Noniwx/Diplom/Диплом/пупупупу/IMG_20250822_150141786.jpg

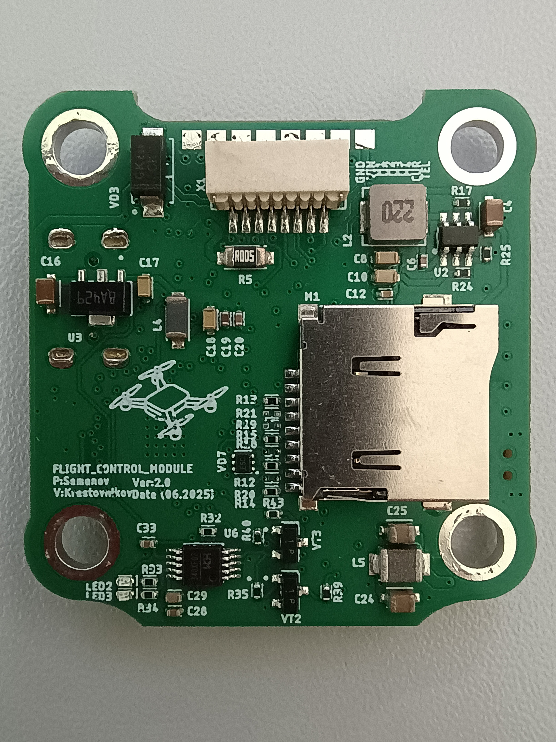
Диплом/пупупупу/IMG_20250822_150141786.jpg
