Noniwx/Diplom/Диплом/пупупупу/IMG_20250822_150113058.jpg

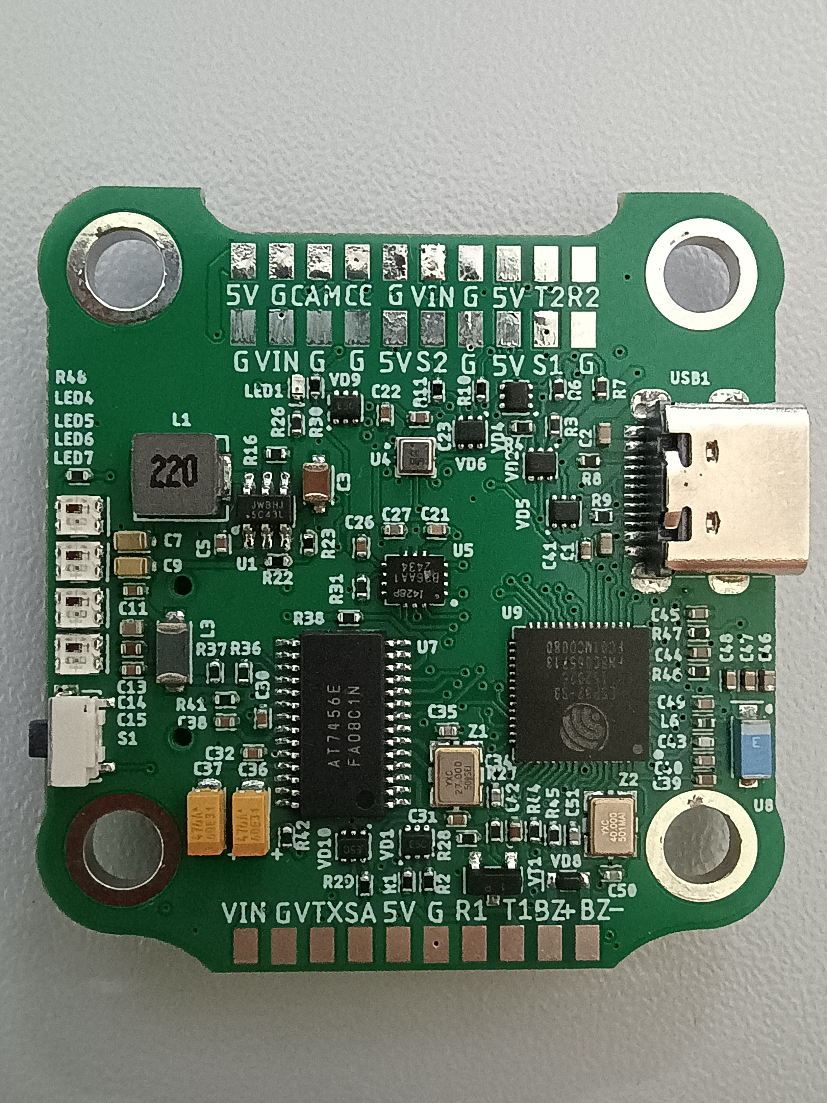
Диплом/пупупупу/IMG_20250822_150113058.jpg
