Noniwx/Diplom/Диплом/План разделов бакалаврской работы.docx

План разделов бакалаврской работы

Тема: Разработка аппаратного решения полётного контролёра FPV БПЛА на базе

микроконтроллера ESP32 [cite: 1]

Автор: Калистратов Яромир Викторович [cite: 1]

Введение

● Определение беспилотного воздушного судна (БВС) и специфика технологииFirst-Person View (FPV)

● Проблема зависимости современного рынка от микроконтроллеров семействаSTM32, приводящая к стагнации новых инженерных решений

● Недостатки одноядерной архитектуры в условиях жесткого реального времени, включая микрозадержки и пропуски тактов управления моторами

● Ограниченность физических интерфейсов в классических решениях (нехватка UART, I2C, SPI)

1. Обзорно-аналитическая часть

1.1 Анализ готовых решений

В разделе проводится детальный сравнительный анализ существующих серийных

полётных контроллеров [cite: 1]:

Модель контроллера Микроконтроллер Ключевые особенности

SpeedyBee F405 V4 [cite: 1] STM32F405 [cite: 1] Высокая интеграция, 6

UART, поддержка Bluetooth

Pixhawk 4 [cite: 1] STM32F765 + STM32F100

[cite: 1]

Для сложных автопилотных

комплексов, богатая

периферия

Matek F405-WTE [cite: 1] STM32F405RGT6 [cite: 1] Наличие Wi-Fi telemetry, до

Модель контроллера Микроконтроллер Ключевые особенности

12 PWM-выходов

Omnibus F4 Pro [cite: 1] STM32F405 [cite: 1] Компактный бюджетный

вариант для базовых задач

стабилизации

1.2 Патентный поиск

● Анализ патентов RU 214483 U1 и RU 2189625 C1 на системы управления БПЛА

● Вывод об избыточной громоздкости запатентованных решений и необходимости

создания высокоинтегрированной архитектуры на базе единого чипа (SoC)

1.3 Постановка технического задания

● Формирование требований к питанию (6-27 В) и габаритам (42 х 39.6 х 8 мм, масса до

8,2 г)

● Выбор микроконтроллера ESP32-S3 в качестве вычислительного ядра

● Требования к сенсорам (IMU, барометр), OSD, записи на MicroSD и подключению

внешней периферии

3. Системное проектирование и

расчетно-теоретическая часть

3.1 Разработка структурной схемы

● Обоснование применения двухъядерного ESP32-S3FN8 для устранения

микрозадержек за счет разделения задач фильтрации и периферийной связи [cite:

1].

● Описание взаимодействия подсистем: комплекса пространственной ориентации,

видеотракта (OSD), каналов управления (ESC) и интерфейсов телеметрии

3.2 Выбор элементной базы

● Обоснование выбора SoC ESP32-S3FN8 с интегрированной Flash-памятью 8 МБ [cite:

1].

● Выбор импульсных (JW5026) и линейных (L78L33) преобразователей для

подсистемы питания

● Подбор сенсорного комплекса: IMU ICM-42688-P и барометр BMP581

● Обоснование чипа MAX7456 для наложения OSD и CH340X для USB-UART моста

3.3 Расчетно-теоретическая часть

● Оценка энергетического баланса: суммарное пиковое потребление составляет ~674

мА по линии 5.0 В

● Расчет номиналов (индуктивность 22 мкГн, выходная емкость) для импульсного

преобразователя JW5026

● Тепловой расчет линейного стабилизатора L78L33 (расчетная температура

кристалла 66.8 °C)

● Проектирование и расчет параметров пассивного RC-фильтра нижних частот для

АЦП измерения напряжения

3.4 Защита и электромагнитная совместимость (ЭМС)

● Использование TVS-диодов (SMAJ30A) и диодных сборок TPNUP4114 для защиты от

индуктивных выбросов ESC и электростатических разрядов

● Разделение цифровых и аналоговых контуров питания, применение локальной

развязки конденсаторами

● Организация механической виброразвязки печатной платы через силиконовые

демпферы для защиты MEMS-гироскопа

4. Решение задач

конструкторско-технологического проектирования

4.1 Выбор материалов и параметров печатной платы

● Применение стеклотекстолита марки FR-4 High-Tg (с температурой стеклования ≥

150 °C) для тепловой стабильности

● Разработка 4-слойной структуры (Stack-up): сигнальные слои (Top/Bottom) и

сплошные полигоны питания/заземления (Inner Power/GND)

● Выбор финишного покрытия ENIG (иммерсионное золочение) для надежного

монтажа компонентов с малым шагом

4.2 Компоновочные решения

● Математическое и физическое обоснование размещения IMU (ICM-42688-P) строго

в центре масс для исключения паразитных центростремительных ускорений

● Минимизация длины проводников высокочастотных шин SPI вокруг

микроконтроллера ESP32-S3

● Периферийное размещение импульсных DC-DC преобразователей для изоляции

электромагнитных помех и отвода тепла

4.3 Трассировка печатной платы

● Реализация импедансного контроля для дифференциальных пар USB (90 Ом) с

применением копланарного волновода

● Трассировка распределительной сети питания (PDN) с помощью заливки медных

полигонов

● Обеспечение непрерывности возвратного тока для защиты шины SPI и

экранирование аналоговых измерительных трактов

● Применение сшивки земляных полигонов (Via Stitching) для краевого экранирования

по принципу клетки Фарадея

4.4 Технологическое обеспечение сборки

● Мультиплицирование (панелизация) плат с использованием фрезеровки с

технологическими перемычками

● Трафаретная печать бессвинцовой паяльной пастой (SAC305) через стальной

трафарет

● Настройка четырехзонного температурного профиля оплавления (предварительный

нагрев, стабилизация, оплавление, охлаждение)

● Внедрение автоматической оптической (AOI) и рентгеновской (X-Ray) инспекции

для скрытых паяных соединений

4.5 Обеспечение теплового режима

● Локализация ключевых источников тепла: ESP32-S3, JW5026, L78L33

● Использование термальных площадок, тепловых переходных отверстий (Thermal

Vias) и внутренних медных слоев как планарных радиаторов для кондуктивного

отвода тепла

● Тепловая изоляция гироскопа от силовых узлов для предотвращения

температурного дрейфа нуля

● Использование фактора конвективного теплообмена за счет нисходящих

турбулентных потоков воздуха от пропеллеров БВС
