Noniwx/Diplom/Диплом/Расчёты.docx

Расчёты

1. Расчёт системы питания (DC-DC и LDO)

- Энергетический баланс (Бюджет мощности): Необходимо составить таблицу токопотребления всех узлов (ESP32-S3, датчики, OSD, внешняя периферия вроде приемника и GPS, светодиоды WS2812). Это обоснует выбор DC-DC преобразователей JW5026.

- Расчёт выходного напряжения DC-DC: Обоснование номиналов резисторов делителя в цепи обратной связи (FB) для получения 5V и 3.3V.

V_(out) =V_(REF) ∙(1+(V_(top))/(V_(bottom)))

- Расчёт индуктивности дросселя (L1, L2): Демонстрация того, почему выбраны именно $22\text{ \mu H}$. Расчёт пульсаций тока дросселя ($\Delta IL$) в зависимости от входного напряжения (например, от 4S или 6S LiPo), частоты переключения и выходного тока.

$$L = \frac{V{OUT} \cdot (V{IN} - V{OUT})}{V{IN} \cdot f{SW} \cdot \Delta IL}$$

- Расчёт пульсаций выходного напряжения и выбор конденсаторов: Обоснование емкости и типа (ESR) выходных конденсаторов для обеспечения стабильности.

- Тепловой расчёт линейного стабилизатора (L78L33): Он питает чувствительную аналоговую часть или датчики. Нужно рассчитать рассеиваемую мощность при падении с 5V до 3.3V и доказать, что он не перегреется без радиатора:

$$PD = (V{IN} - V{OUT}) \cdot I{LOAD}$$

$$TJ = TA + PD \cdot \theta{JA}$$

2. Расчёт высокочастотных цепей и тактирования

Поскольку используется микроконтроллер с радиомодулем и высокоскоростные шины, этот блок покажет твои компетенции в СВЧ.

- Согласование волнового сопротивления антенны: Расчёт ширины микрополосковой линии от вывода LNAIN ESP32 до разъема антенны для обеспечения импеданса $50\text{ Ом}$. Это потребует указания параметров стека печатной платы (материал FR4, толщина диэлектрика, толщина меди).

- Расчёт нагрузочной емкости кварцевого резонатора (40 МГц): Обоснование выбора конденсаторов $22\text{ pF}$ (C49, C50) на основе паразитной емкости монтажа ($C{stray}$) и спецификации самого кварца:

$$CL = \frac{C1 \cdot C2}{C1 + C2} + C_{stray}$$

3. Расчёт сигнальных и измерительных цепей

Этот блок покажет понимание работы с аналоговыми сигналами и защитой.

- Расчёт делителя напряжения для АЦП (Мониторинг батареи): На разъеме X1 (Sheet 1/4) есть вход VIN, который через делитель (R5, R6, R7 - нужно уточнить номиналы на схеме, там указано $0.005$ для шунта и делитель для напряжения) идет на АЦП. Нужно рассчитать коэффициент деления так, чтобы максимальное напряжение батареи (например, $25.2\text{ V}$ для 6S) не превышало опорное напряжение АЦП ESP32.

- Токоизмерительный шунт: Расчёт падения напряжения на шунте (если он установлен на плате) или расчёт цепи усилителя токового сигнала с ESC. Обоснование рассеиваемой на шунте мощности $P = I^2 \cdot R$.

- Ограничительные резисторы для светодиодов: Классический, но обязательный расчёт резисторов для индикаторных LED, чтобы ток не превысил возможности пинов MCU.

4. Конструкторско-технологические расчёты (Для ГОСТ/ЕСКД)

Если комиссия любит классическую школу проектирования, эти пункты добавят работе огромный вес.

- Расчёт надежности (Наработка на отказ - MTBF): Приблизительный расчет вероятности безотказной работы платы в течение заданного времени на основе интенсивности отказов компонентов (по справочникам или MIL-HDBK-217F). Для полетного контроллера FPV, который подвергается вибрациям и крашам, это очень интересный пункт.

- Оценка габаритов и трассировки: Обоснование выбора класса точности печатной платы (ширина проводников/зазоры) исходя из протекающих токов (особенно в цепях питания от батареи).

С какого раздела расчётов ты бы хотел начать детальную проработку для добавления в текст пояснительной записки?
