Noniwx/Diplom/Диплом/1.docx

1.1 Анализ существующих аппаратных платформ полетных контроллеров и их архитектурных ограничений

Основой любого современного БВС является полетный контроллер, который определяет функциональные возможности аппарата и его итоговую стоимость. Однако на сегодняшний день достижение баланса между высокой производительностью и экономической доступностью существенно затруднено. Анализ готовых проектов с открытым аппаратным обеспечением показывает, что подавляющее большинство современных полетных контроллеров базируется на 32-битных микроконтроллерах семейства STM32 (таблица 1).

Таблица 1 - Сравнение микроконтроллеров, датчиков и лицензий для платформ полетных контроллеров с открытым аппаратным обеспечением [2]

Тотальная зависимость рынка от чипов семейства STM32 стала причиной формирования весьма консервативной экосистемы. Популярные открытые проекты, наподобие Pixhawk, изначально создавались с оглядкой именно на эту архитектуру. В результате инженеры оказались зажаты в строгие рамки, так как выбор компонентов сильно ограничен, а любые попытки выйти за пределы аппаратной линейки, сталкиваются с серьезными трудностями.

При глубоком рассмотрении технической стороны вопроса, базовая проблема таких полетных контроллеров кроется в использовании всего одного вычислительного ядра. Логика управления полетом требует работы в реальном времени, из-за чего все ключевые процессы, а именно чтение показаний датчиков, математика ПИД-регуляторов и программная очистка сигналов от шума - выстраиваются в единую последовательную очередь. Как только применяемые алгоритмы усложняются, к примеру, добавляется тяжелая динамическая RPM-фильтрация, процессор начинает банально не справляться с потоком вычислений. Возникает задержка базового рабочего цикла, плата пропускает такты управления двигателями, и БВС теряет стабильность в воздухе.

Также к вычислительным ограничениям, при проектировании постоянно возникает проблема дефицита физических портов связи. Для полноценного функционирования современного БВС к нему необходимо одновременно подключить модуль навигации, камеру и двустороннюю телеметрию. В недорогих микроконтроллерах такого количества независимых линий связи нет. Инженерам приходится искать компромиссы: делить одну шину между несколькими устройствами или эмулировать порты программными средствами. На практике же такие обходные пути ведут к конфликтам контроллеров прямого доступа к памяти и потере пакетов данных.

Для разработки полетного контроллера необходимо подобрать оптимальный микроконтроллер. Для этого провести сравнительный анализ современных микропроцессоров. В качестве объектов для сравнения выбраны три актуальные микроконтроллера: STM32F405, RP2040 и ESP32-S3.

1.2.1 Микроконтроллер STM32F405

Микроконтроллер семейства STM32 является наиболее распространенным решением, применяемым в подавляющем большинстве современных полетных контроллеров для FPV-систем.

- Архитектура: ARM Cortex-M4;

- Количество ядер: 1;

- Максимальная тактовая частота: 168 МГц;

- Аппаратная поддержка FPU-есть;

- Беспроводные интерфейсы-нет

- Особенности ввода-вывода: аппаратные шины, UART, I2C, SPI, имеют жесткую привязку к конкретным физическим выводам чипа.

1.2.2 Микроконтроллер RP2040

Микроконтроллер RP2040 представляет собой современное бюджетное решение с уникальной подсистемой программируемого ввода-вывода, набирающее популярность в DIY-электронике.

- Архитектура: ARM Cortex-M0+;

- Количество ядер: 2;

- Максимальная тактовая частота: 133 МГц;

- Аппаратная поддержка FPU -нет

- Беспроводные интерфейсы -нет

- Особенности ввода-вывода: программируемые блоки ввода-вывода PIO, позволяющие эмулировать интерфейсы на любых выводах.

1.2.3 Микроконтроллер ESP32-S3

Микроконтроллер ESP32-S3 - высокопроизводительная система на кристалле SoC с фокусом на интеграцию беспроводных технологий и параллельные вычисления.

- Архитектура: Xtensa LX7;

- Количество ядер: 2;

- Максимальная тактовая частота: 240 МГц;

- Аппаратная поддержка FPU -есть;

- Беспроводные интерфейсы: встроенные Wi-Fi 4 и Bluetooth 5;

- Особенности ввода-вывода: аппаратный матричный коммутатор GPIO Matrix, позволяющий произвольно назначать периферийные шины на любые физические выводы.

Для наглядного сопоставления ключевых параметров рассмотренных вычислительных платформ составлена сводная таблица (таблица 1.2).

Таблица 1.2 - Сравнительная характеристика микроконтроллеров

Название | STM32F405 | RP2040 | ESP32-S3
Архитектура | ARM Cortex-M4 | ARM Cortex-M0+ | Xtensa LX7
Количество ядер | 1 | 2 | 2
Максимальная тактовая частота | 168 МГц | 133 МГц | 240 МГц
Аппаратный FPU | Есть | Нет | Есть
Встроенная беспроводная связь | Нет | Нет | Wi-Fi 4, Bluetooth
Гибкость портов вывод-ввод | Низкая | Высокая | Высокая

Анализ характеристик показывает, что микроконтроллер ESP32-S3 является наиболее сбалансированным решением для разрабатываемого устройства. В отличие от STM32F405, он обладает двухъядерной архитектурой, позволяющей эффективно разделить вычислительные потоки контура стабилизации и навигации, а также имеет на борту встроенные радиомодули для организации беспроводной сервисной телеметрии. В отличие от RP2040, ядро ESP32-S3 оснащено аппаратным сопроцессором FPU, что является критически важным условием для быстрого расчета ПИД-регуляторов и цифровых фильтров без просадок по частоте главного цикла. Дополнительным фактором выбора служит наличие GPIO Matrix, что радикально упростит трассировку печатной платы при подключении внешних датчиков.

Для выполнения требований методических указаний в данном подразделе необходимо провести патентное исследование. Цель поиска - анализ существующих запатентованных технических решений в области архитектуры и компоновки бортовых полетных контроллеров для беспилотных летательных аппаратов, а также подтверждение патентной чистоты разрабатываемого устройства.

Поиск проводился по фондам Федерального института промышленной собственности (ФИПС), а также по международным базам данных (Espacenet, Google Patents) с использованием индексов Международной патентной классификации (МПК): B64C 39/02 (беспилотные авиационные системы) и G05D 1/00 (управление или регулирование положения в пространстве).

Ниже приведены результаты анализа наиболее близких по технической сущности патентов.

1.3.1 Патент РФ No 2712534 "Бортовой модульный комплекс управления беспилотным летательным аппаратом"

- Правообладатель: АО "Концерн "Вега"

- Суть технического решения: Патент описывает архитектуру модульного полетного контроллера, построенного на базе центрального вычислителя и распределенной сети датчиков пространственной ориентации. Связь между модулями внутри устройства осуществляется по помехозащищенной шине.

- Достоинства: Высокая отказоустойчивость за счет дублирования измерительных каналов и модульной структуры.

- Недостатки и отличия: Высокая сложность аппаратной реализации, избыточная для малых FPV-систем масса и габариты, а также высокая стоимость элементной базы. В разрабатываемом проекте вместо громоздкой модульной структуры применяется моноблочная печатная плата на базе высокоинтегрированной системы на кристалле (SoC).

1.3.2 Патент США (US) No 11249492 "Flight Controller for Unmanned Aerial Vehicles with Integrated Wireless Interface"

- Правообладатель: SZ DJI Technology Co., Ltd.

- Суть технического решения: Изобретение относится к архитектуре полетного контроллера со встроенным на кристалл или печатную плату высокочастотным приемопередатчиком для передачи сервисных данных, телеметрии и настройки конфигурации без использования проводных интерфейсов.

- Достоинства: Улучшенные массогабаритные показатели (SWaP) за счет исключения внешних мостов связи и интерфейсных микросхем.

- Недостатки и отличия: Заявленное в патенте решение базируется на закрытой проприетарной архитектуре и специализированных чипах связи, что делает невозможным его использование в бюджетных открытых платформах. Разрабатываемый проект использует схожий концептуальный подход (встроенный радиоканал), но реализует его на базе общедоступного микроконтроллера ESP32-S3 и открытых протоколов, что снижает себестоимость платы.

Сводная таблица патентного поиска

Для наглядного сравнения патентных решений и разрабатываемого устройства составлена таблица 1.3.

Таблица 1.3 - Матрица сравнения патентных решений

| Критерий сравнения | Патент РФ No 2712534 | Патент US No 11249492 | Разрабатываемое устройство |

| Конструктивное исполнение | Модульное (многоплатное) | Моноблочное | Моноблочное (одна печатная плата) |

| Аппаратная база | Проприетарные вычислители | Специализированная SoC DJI | Общедоступный SoC ESP32-S3 |

| Интегрированная беспроводная связь | Нет | Есть (закрытый протокол) | Есть (открытые Wi-Fi / Bluetooth) |

| Целевой сегмент рынка | Тяжелые БАС (спец. назначение) | Гражданские коммерческие БВС | Доступные FPV-системы, DIY |

Вывод по патентному поиску:

Анализ патентной документации показывает, что архитектурные решения, закладываемые в разрабатываемый полетный контроллер (моноблочная плата на базе ESP32-S3 с интегрированными датчиками и встроенным сервисным беспроводным интерфейсом), обладают патентной чистотой. Проектируемое устройство не нарушает действующих прав патентных правообладателей, так как базируется на принципиально иной, общедоступной элементной базе и оригинальной топологии печатной платы, адаптированной под жесткие экономические рамки гражданских FPV-систем.

2.1 Разработка структурной схемы полетного контроллера

Системное проектирование аппаратного модуля начинается с определения его ключевых функциональных узлов, необходимых для выполнения поставленного технического задания. Центральным координирующим ядром разрабатываемой системы является микроконтроллер ESP32-S3FN8. Для обеспечения полного цикла управления беспилотным воздушным судном - от сбора телеметрии до выдачи корректирующих воздействий на моторы - вокруг центрального процессора формируется инфраструктура из следующих логических подсистем:

1. Подсистема питания и мониторинга

Первичным источником энергии на борту выступает аккумуляторная батарея. Подсистема питания предназначена для понижения и стабилизации входного напряжения до уровней, необходимых для корректной работы центрального микроконтроллера и чувствительной периферии. Параллельно с этим в систему закладывается блок измерения напряжения, который непрерывно опрашивает состояние батареи и передает данные в микроконтроллер для контроля уровня разряда и предотвращения аварийных ситуаций.

2. Измерительный комплекс

Для реализации алгоритмов стабилизации микроконтроллеру требуется непрерывный поток данных о пространственном положении аппарата. В этот комплекс входят инерциальный датчик пространственного положения (гироскоп и акселерометр) и барометр для определения абсолютной высоты. Обмен данными между датчиками и процессором осуществляется по высокоскоростным цифровым шинам.

3. Видеоподсистема

Отвечает за формирование FPV-сигнала. Аналоговый видеопоток с курсовой камеры поступает в специализированный модуль OSD. В этом блоке центральный микроконтроллер аппаратно накладывает на видеоряд полетную

телеметрию. Сформированный сигнал передается на видеопередатчик для трансляции на приемное оборудование пилота.

4. Подсистема связи и внешних интерфейсов

Обеспечивает взаимодействие контроллера с оператором и внешним миром. В нее входят:

- Приемник ELRS для получения управляющих команд с пульта пилота;
- Приемник GPS для определения глобальных координат;
- Модуль SD-CARD для непрерывного логирования полетных данных;
- USB-интерфейс, позволяющий осуществлять сервисную настройку и прошивку контроллера с персонального компьютера.

5. Блок исполнительных устройств и индикации

На основе математических расчетов ПИД-регулятора микроконтроллер формирует управляющие сигналы, которые передаются на блок регуляторов оборотов. Регуляторы скорости коммутируют силовые токи для вращения бесколлекторных моторов. Дополнительно предусмотрены выходы для управления сервоприводами и блок индикации для обеспечения визуальной и звуковой обратной связи с пилотом на земле.

На основе описанных выше функциональных узлов и связей между ними была разработана структурная схема полетного контроллера, наглядно отражающая направления информационных и энергетических потоков (рисунок 2.1).

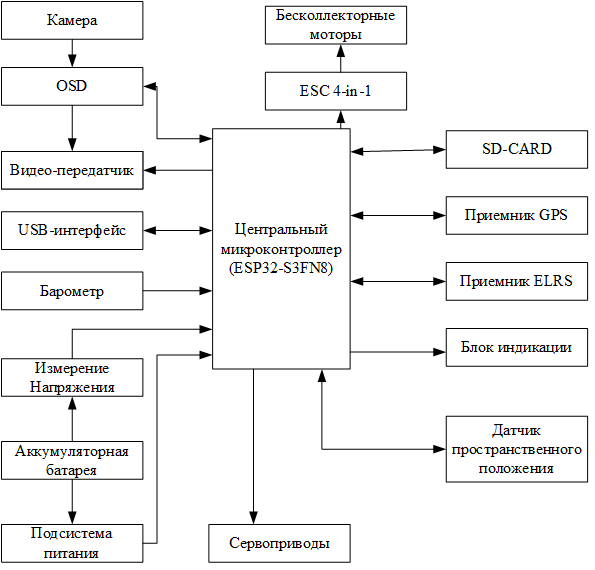
[picture p13: figure]

Рисунок 2.1 - Структурная схема полетного контроллера

Данная структура полностью покрывает аппаратные потребности разрабатываемого устройства и служит строгим базисом для последующей разработки функциональной и принципиальной электрических схем.
