Noniwx/Diplom/Диплом/ВВЕДЕНИЕ.docx

Беспилотное воздушное судно представляет собой летательный аппарат, который выполняет полет без экипажа на борту и управляется дистанционно внешним пилотом либо функционирует в полностью автономном режиме. Законодательно закрепленная формулировка определяет его как "Беспилотное воздушное судно - воздушное судно, управляемое, контролируемое в полете пилотом, находящимся вне борта такого воздушного судна (внешний пилот). " [1]. Развитие подобных систем стало возможным благодаря уменьшению электронных компонентов, что позволило превратить тяжелые комплексы в компактные маневренные платформы, пригодные для решения широкого спектра задач.

Аппаратная часть современных беспилотных воздушных суден базируется на несущей конструкции- раме, силовой установке, которая представляет собой набор из бесколлекторных двигателей и электронных регуляторов скорости, источнике питания и полётном контроллере, который выступает главным вычислительным узлом для обработки данных с датчиков и стабилизации. Конструктивно такие аппараты делятся на несколько основных классов, среди которых для решения тактических и маневренных задач доминируют крылатые и роторные платформы [2]. Среди роторных систем очень хорошо выделяются системы, с технологией First-Person View, что дословно переводится как «вид от первого лица». Суть этой технологии заключается в непрерывной передаче видеопотока с бортовой камеры на очки или монитор пользователя с минимальными задержками. Это дает оператору БВС эффект нахождения непосредственно в кабине и позволяет выполнять сложные пространственные маневры на высоких скоростях, быстро реагировать, а также огибать препятствия.

Именно способность FPV БВС и мультироторных систем маневрировать в труднодоступных местах позволила их массовое внедрение различные секторы гражданской авиации. Беспилотные воздушные судна стали стандартным инструментом для решения задач, где требуется оперативный сбор пространственных данных или визуальный контроль. Они активно применяются для инспекции строительных площадок, мониторинга сельскохозяйственных угодий, обеспечения безопасности и проведения поисково-спасательных работ [3]. Применение БВС исключает риск для жизни человека при обследовании опасных зон, таких как очаги возгораний или разрушенные здания, делая разработку доступной аппаратной базы для таких устройств критически важной задачей.

Массовое внедрение БВС в различные секторы гражданской авиации требуют создания экономически эффективных аппаратных решений. Однако достижение баланса между низкой себестоимостью и высокой производительностью существенно затруднено текущим состоянием рынка электронных компонентов. Подавляющее большинство современных аппаратных решений для FPV-систем жестко привязано к микроконтроллерам семейства STM32 (таблица 1) с архитектурой ARM Cortex-M. Исторически эта архитектура стала базовой для ключевых проектов с открытым исходным кодом, таких как Betaflight и INAV, что привело к формированию стандартизированной, но замкнутой аппаратно-программной экосистемы [4]. Данная унификация упрощает сборку типовых летательных аппаратов, однако накладывает жесткие рамки на компонентную базу. Следствием подобной монополизации является критическое снижение инженерной гибкости при проектировании новых систем управления. Разработчики полетных контроллеров оказываются в зависимости от конкретной компании и узкой линейки процессоров. В ситуациях, требующих максимального снижения себестоимости платы или глубокой аппаратной интеграции беспроводных интерфейсов связи, безальтернативная опора на STM32 становится фундаментальным препятствием для перехода на альтернативные вычислительные платформы и снижение итоговой стоимости плат.

Таблица 1 - Сравнительный анализ аппаратных платформ полетных контроллеров (по данным [4])

Главным недостатком классической архитектуры микроконтроллеров, доминирующих на рынке БВС, является использование одного вычислительного ядра. Система управления полетом функционирует в режиме жесткого реального времени и требует непрерывного выполнения вложенных циклов, где абсолютным приоритетом обладает высокочастотный внутренний контур стабилизации [5]. В одноядерной системе опрос гироскопов, расчет ПИД-регуляторов, фильтрация шумов и обработка входящих команд от пилота выполняются строго последовательно. При усложнении математического аппарата, например, при внедрении ресурсоемких алгоритмов динамической RPM-фильтрации, единственное ядро подвергается критическим перегрузкам. Последовательная обработка возрастающего потока данных приводит к неизбежным задержкам времени выполнения базового цикла [4]. Возникающие микрозадержки вызывают пропуски тактов управления моторами, что напрямую снижает стабильность БВС.

Аппаратные ограничения вычислительного ядра дополнительно усугубляются нехваткой физических интерфейсов для взаимодействия с внешней периферией. Современные задачи требуют одновременного подключения к контроллеру цифровых систем видеопередачи, GPS-модулей, барометров и линий двунаправленной телеметрии. Для их интеграции требуются независимые аппаратные протоколы, такие как UART, I2C, SPI, однако их количество в недорогих чипах жестко ограничено, что наглядно отраженно на структурной схеме типового подключения периферии (рисунок 1) [6]. Исчерпание доступных аппаратных шин вынуждает прибегать к программной эмуляции протоколов или совместному использованию линий. Это провоцирует конфликты на уровне контроллеров прямого доступа к памяти, приводит к потере пакетов данных и делает классические контроллеры трудно масштабируемыми под требования современных систем.

Рисунок 1 - Структурная схема аппаратных конфликтов при подключении периферийных модулей
