Noniwx/Diplom/Диплом/пупупупу/Презентация1.pptx

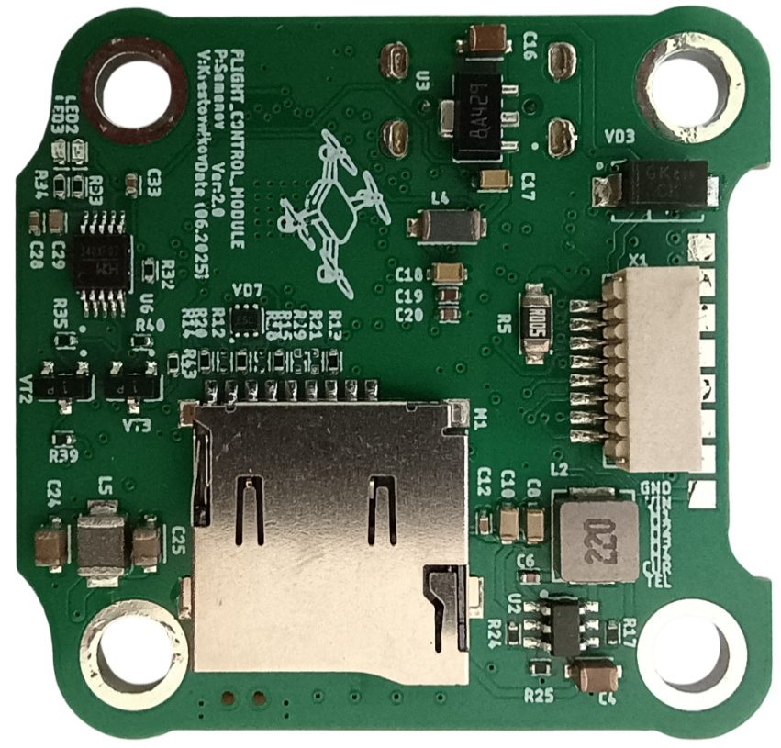
[picture p29: figure]
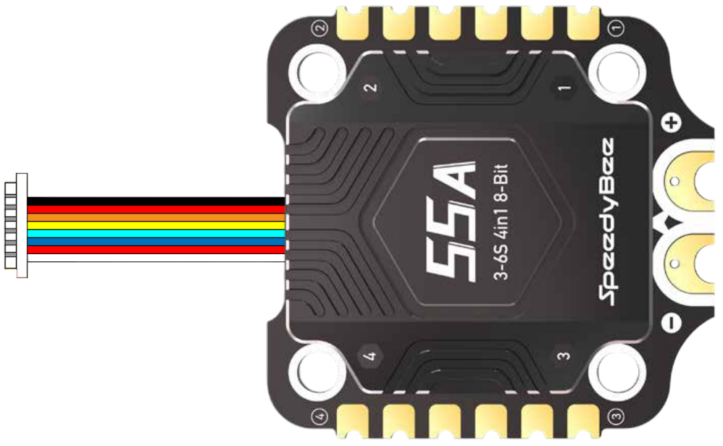
[picture p30: figure]

## Slide 2

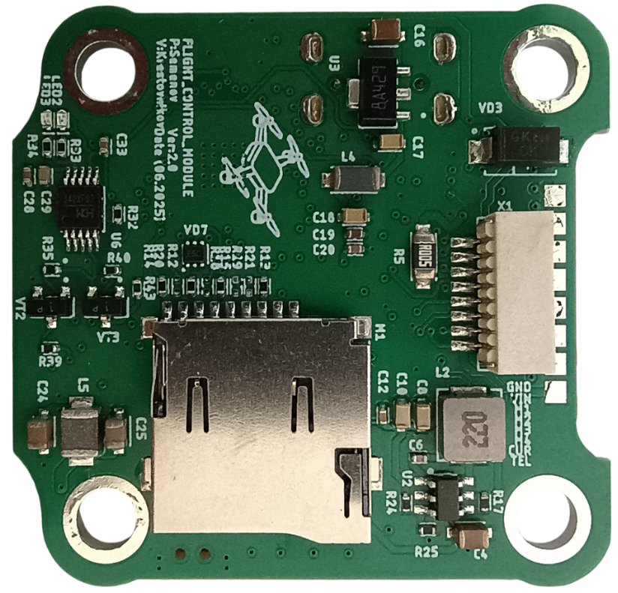
[picture p31: figure]
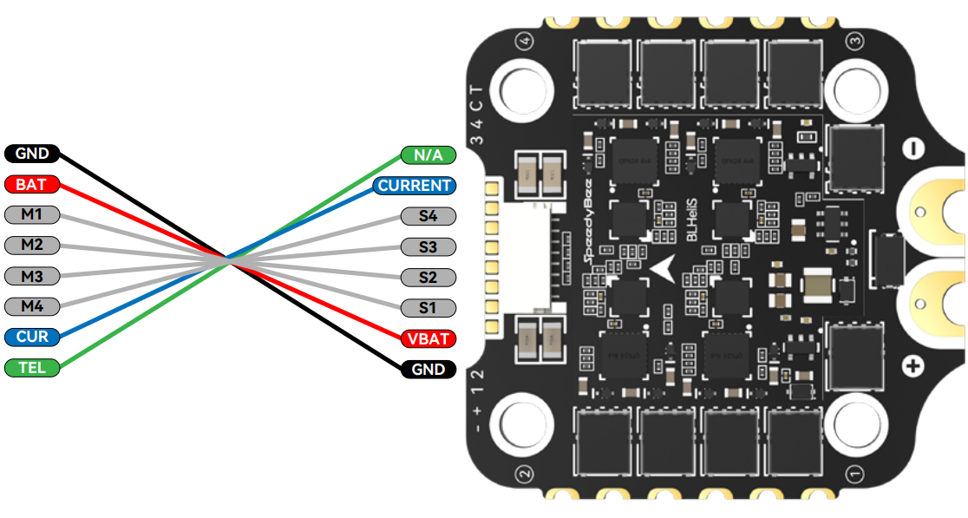
[picture p32: figure]

## Slide 3

DC-DC понижающий

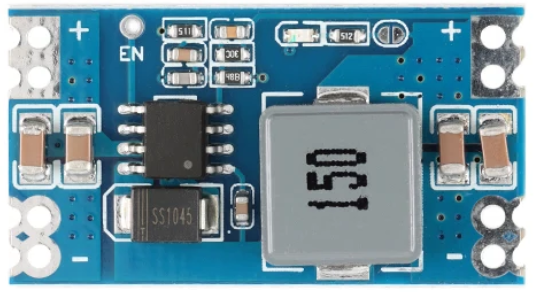
[picture p33: figure]

Сервопривод 1
(сброс, камера)

Сервопривод 2
(сброс, камера)

АКБ БпЛА

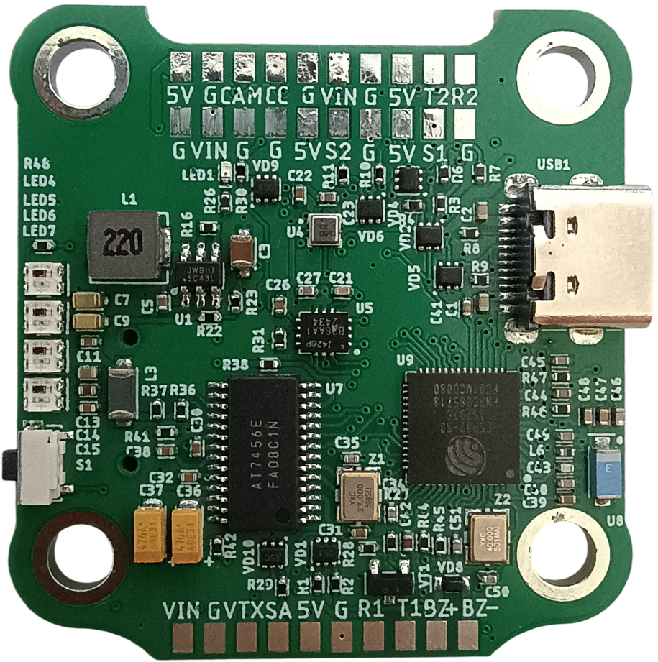
[picture p34: figure]

## Slide 4

DC-DC понижающий

Сервопривод 1
(сброс, камера)

Сервопривод 2
(сброс, камера)

АКБ БпЛА

Электрический
детонатор
промышленный
(ЭДП, ЭД-8)
