Noniwx/Diplom/Диплом/Structure.png

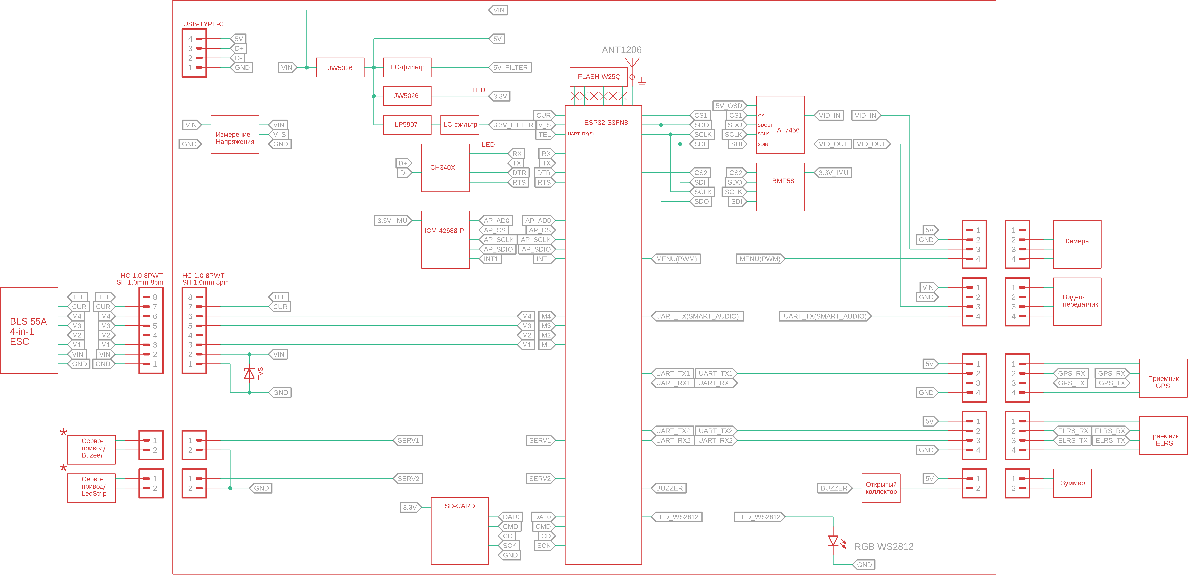
Диплом/Structure.png
