Noniwx/Diplom/Диплом/пупупупу/ESC-FC-Photoroom.png

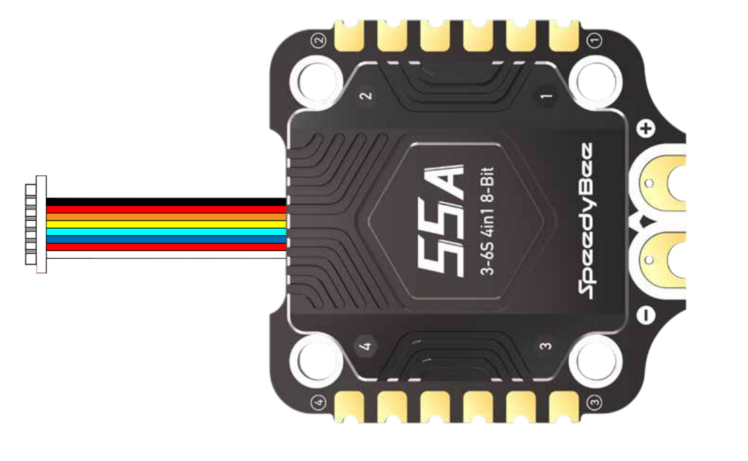
Диплом/пупупупу/ESC-FC-Photoroom.png
