Noniwx/Diplom/Диплом/пупупупу/GPS.png

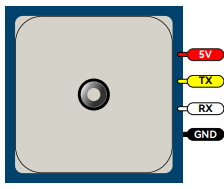
Диплом/пупупупу/GPS.png
