Noniwx/Diplom/Диплом/пупупупу/IMG_20250822_150113058-Photoroom.png

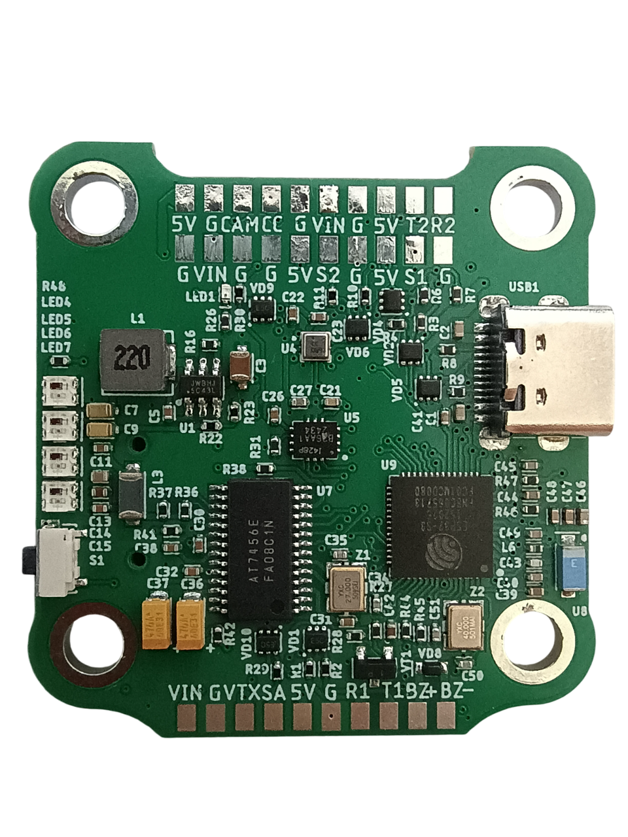
Диплом/пупупупу/IMG_20250822_150113058-Photoroom.png
