Noniwx/Diplom/Диплом/пупупупу/IMG_20250822_150141786-Photoroom.png

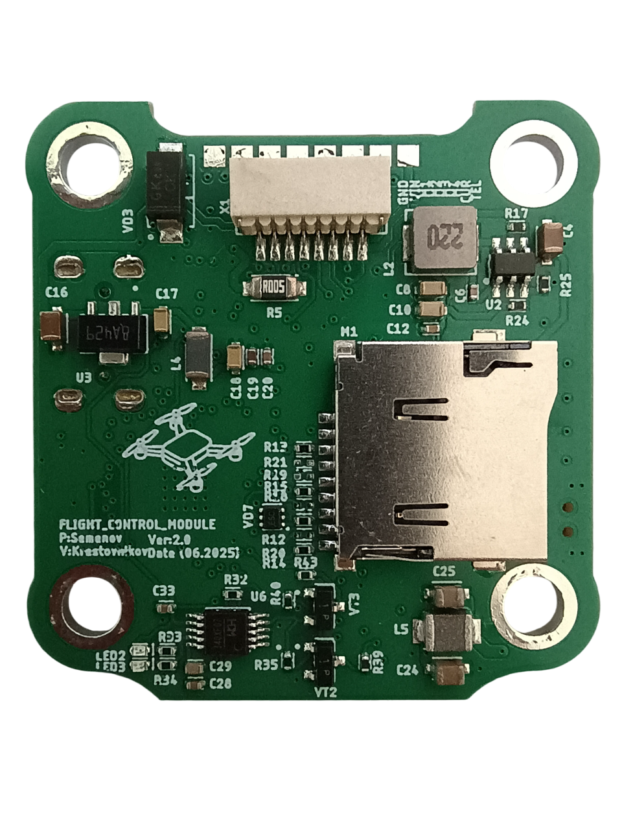
Диплом/пупупупу/IMG_20250822_150141786-Photoroom.png
