Noniwx/Diplom/Диплом/пупупупу/photo_2026-05-30_10-07-58.jpg

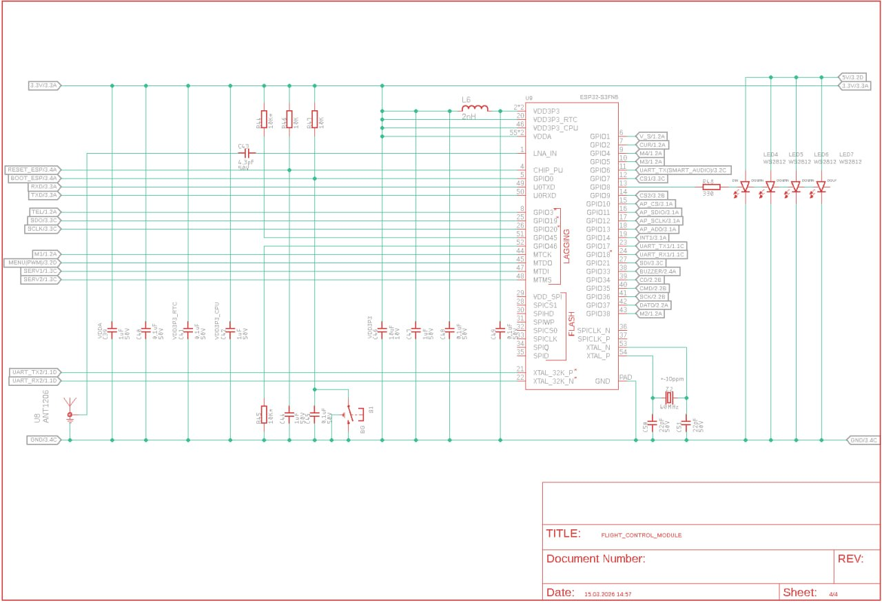
Диплом/пупупупу/photo_2026-05-30_10-07-58.jpg
