Noniwx/Diplom/Диплом/пупупупу/photo_2026-05-30_10-08-17.jpg

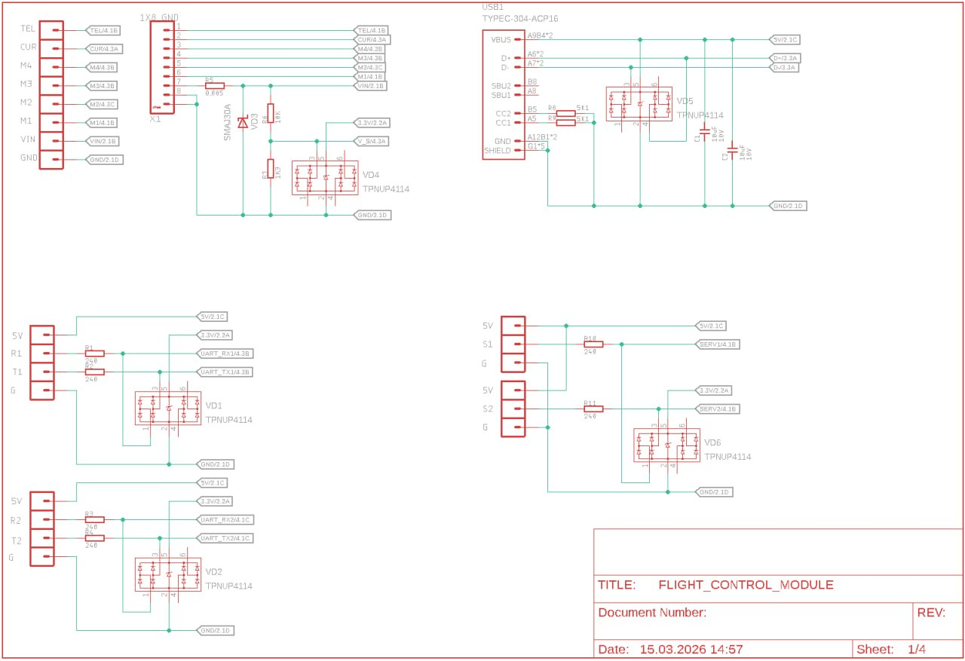
Диплом/пупупупу/photo_2026-05-30_10-08-17.jpg
