Noniwx/Diplom/Диплом/пупупупу/vtx.png

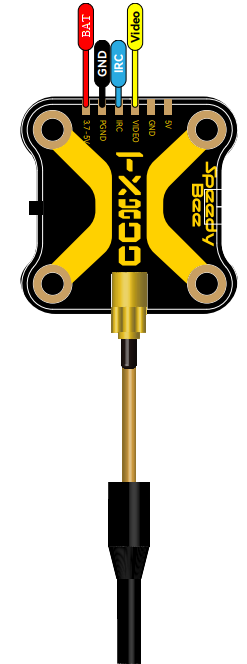
Диплом/пупупупу/vtx.png
