Noniwx/Diplom/Диплом/папапапа/BOM_FLIGHT_CONTROL_MODULE.pdf

Номер

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
Обозначение Элемента

C1, C2, C13, C29, C46
C14, C19, C39, C42, C44, C47 C21
C27
C36, C37
C5, C6, C11, C12, C15, C20, C22, C23, C26, C28, C30, C31, C32, C33, C38, C40, C41, C45, C48, C49
C3, C4, C16
C7, C8, C9, C10, C17, C18
С43
C24, C25
C34, C35, C50, C51

R1, R2, R3, R4, R10, R11, R12, R13, R14, R15, R29, R30 R5
R22
R23
R24
R25
R26, R27, R33, R34, R36, R37, R38, R39, R43 R32
R35, R40
R41, R42
R48
R6, R16, R17, R28, R31, R44, R45, R46, R47 R7
R8, R9

VD8
VD1, VD2, VD4, VD5, VD6, VD7, VD9, VD10 VD3

VT1, VT2, VT3

Z1
Z2

LED4, LED5, LED6, LED7
LED1, LED3
LED2

S1

U1, U2
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
USB1

L5
L3, L4
L1, L2
L6

U8

Количество | Парт номер
5 | CL05A106MP5NUNC 6 | GRM155R61H105KE05D 1 | CL05B103KB5NNNC 1 | CL05A225MQ5NSNC 2 | TLJA476M010R0600
20 | CL05B104KB54PNC 3 | CGA0805X5R226M350MT 6 | GRM188R60J476ME15D 1 | GJM1555C1H4R3CB01D 2 | CL21A475KBQNNNE 4 | 0402CG220J500NT
12 | RC0402FR-07240RL 1 | RLM12FTCMR005 1 | RC0402FR-0711K3L 1 | RC0402FR-072K1L 1 | 0402WGF7501TCE 1 | 0402WGF2401TCE 9 | 0402WGF1001TCE 1 | 0402WGF4701TCE 2 | 0402WGF4700TCE 2 | 0402WGF750JTCE 1 | 0402WGF3300TCE 6 | 0402WGF1002TCE 1 | RC0402FR-071K3L 2 | 0402WGF5101TCE 1 | 1N5819WS 8 | NUP4114UPXV6T1G-N 1 | SMAJ30A 3 | MMBT2222A 1 | X322527MSB4SI 1 | X322540MMB4SI

4 | WS2812B-2020 2 | SZYY0402R 1 | SZYY0402YG 1 | TS-1010-C-A 2 | JW5026 1 | L78L33ABUTR 1 | BMP581 1 | ICM-42688-P 1 | CH340X 1 | AT7456 1 | ESP32-S3FN8 1 | HC-1.0-8PWT 1 | GT-TF003-H0185-02 1 | TYPEC-304-ACP16 1 | SMMS0850-2R2M 2 | MGFL3216F100MT-LF 2 | SMMS0420-220M 1 | LQG15HS2N0S02D 1 | RFANT3216120A5T

Описание/номинал

10uF
1uF
10nF
2.2uF
47uF

100nF

22uF
47uF
4.3pF
4.7uF
22pF

240
0.005Ω
11K3
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
Electrostatic and Surge Protection SMAJ30A

40V 300mW 600mA NPN

27MHz
40MHz Surface mount crystal oscillator 10pF ±10ppm ±20ppm SMD3225-4P

Конденсаторы

Резисторы

Диоды, стабилитроны

Транзисторы

Кварцевые резонаторы

WS2812
Red
Green

BG

L78L33
BMP581
ICM-42688-P
CH340X
AT7456
ESP32-S3FN8

3A 1 Surface Mount，Right Angle 16P

2.2uH
10uH
22uH
2nH

2 2dBi 2.4GHz

Антенны

Индуктивность

Переключатели

Микросхемы

Разъемы

Светодиоды

Корпус

0402
0402
0402
0402
CASE-A-3216

0402

0805
0603
0402
0805
0402

0402
1206
0402
0402
0402
0402
0402
0402
0402
0402
0402
0402
0402
0402

SOD-523
SOT-563
SMA

SOT-23

SMD3225-4P
SMD3225-4P

SMD,2.2X2MM
0402
0402

SMD

SOT-23-6
SOT-89
LGA-10(2x2)
LGA-14(2.5X3)
MSOP-10
TSSOP-28P
QFN-56-EP(7X7)

SMD,P=1mm,Surface Mount，Right Angle SMD

1210
1206
0420CDMC
0402

1206

Доп. Информация

10V 10uF X5R
50V 1uF X5R
50V 10nF X7R
16V 2.2uF X5R
47uF 10V

50V 100nF X7R

35V 22uF X5R
6.3V 47uF X5R
50V 4.3pF C0G
50V 4.7uF X5R
50V 22pF C0G

62.5mW
1W 5mΩ 1206
62.5mW
62.5mW
62.5mW
62.5mW
62.5mW
62.5mW
62.5mW
62.5mW
62.5mW Thick Film Resistors 50V ±100ppm/℃ ±1% 330Ω 0402 Chip Resistor - Surface Mount ROHS 62.5mW
62.5mW
62.5mW

C2901318

1x8P 8P SH, Right Angle,P=1mm

2.7A 2.2uH ±20% 3.3A 77mΩ
670mA 10uH ±20% 500mΩ
1.2A 22uH
900mA

2 2dBi Chip antenna 2.4GHz 1206

Номер LCSC

C315248
C1518208
C15195
C12530
C131173

C307331

C6119901
C140782
C161325
C98192
C1555

C114755
C316225
C189473
C163473
C25918
C25882
C11702
C25900
C25117
C25133
C25104
C25744
C185455
C25905

C5185918
C6165141
C908776

C8512

C9008
C5210647

C965555
C434445
C434449

C692458

C185109
C81362
C5362283
C1850418
C3035748
C82351
C2913196

C2845367
C5155564
C2982555

C5331030
C281117
C2894720
C18216

C127629
