Noniwx/Diplom/Диплом/Деталь1.SLDPRT

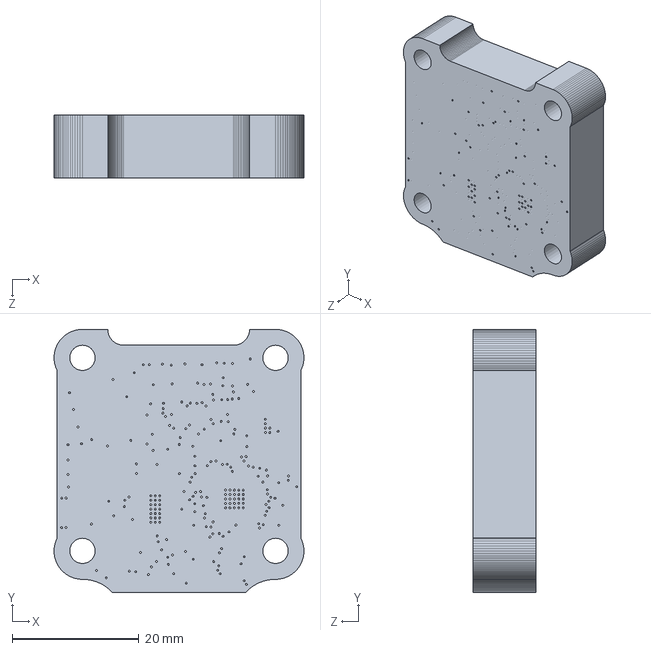
[picture p66: CAD file, 2026-06-07]
Диплом/Деталь1.SLDPRT
39.5 x 41.6 x 10.0 mm
