Noniwx/Diplom/Диплом/папапапа/10.pdf

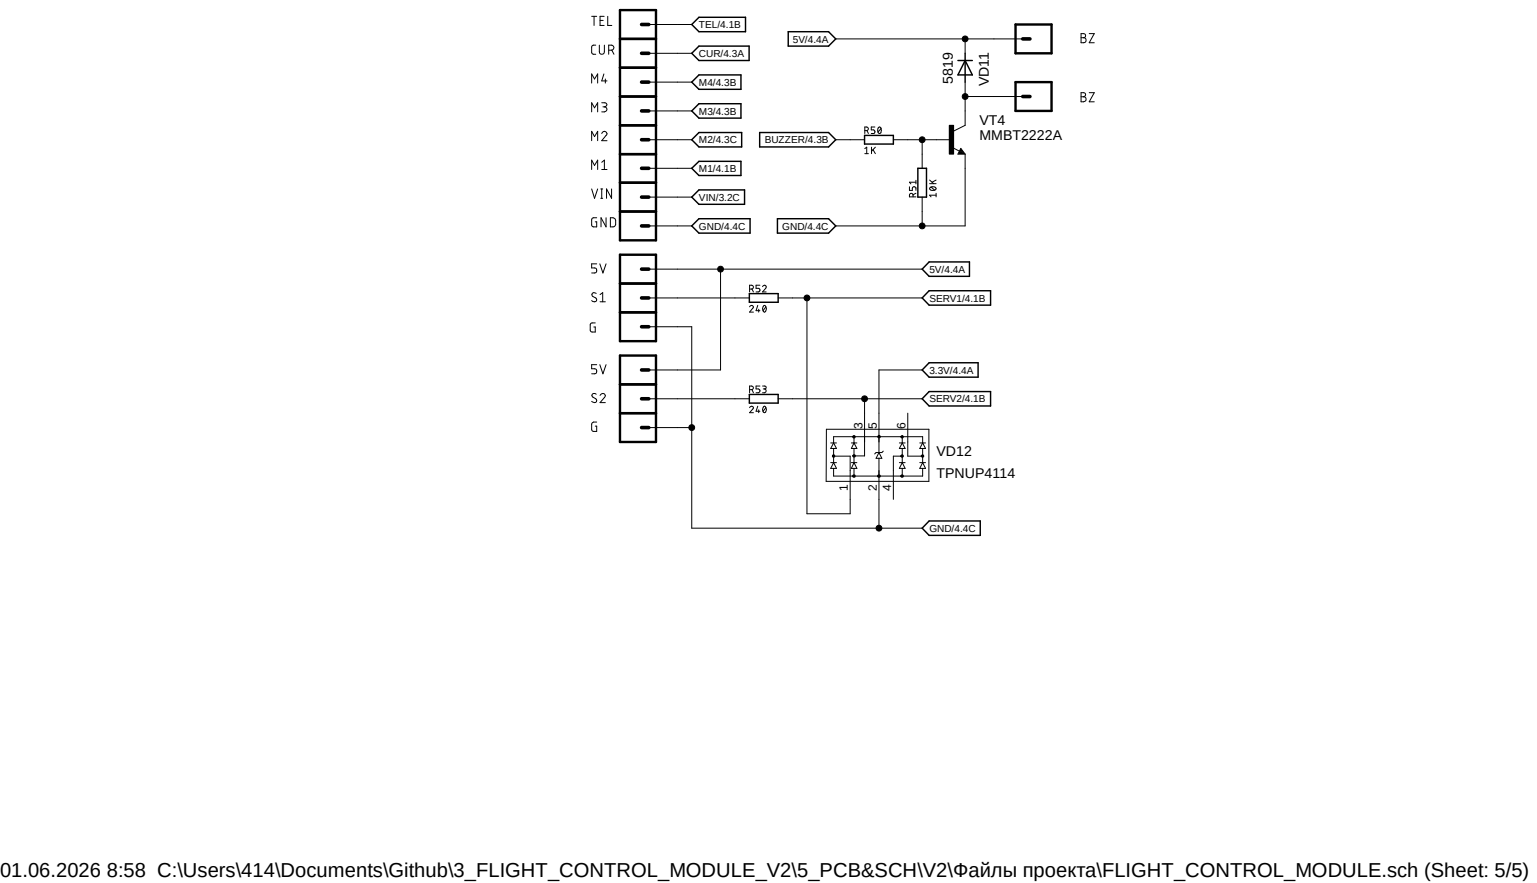
[picture p67: page 1]
MMBT2222A ⁵⁸¹⁹; TPNUP4114; VT4VD¹¹; GND/4.4C; CUR/4.3A; TEL/4.1B; VIN/3.2C; BUZZER/4.3B; SERV1/4.1B; SERV2/4.1B

01.06.2026 8:58 C:\Users\414\Documents\Github\3_FLIGHT_CONTROL_MODULE_V2\5_PCB&SCH\V2\Файлы проекта\FLIGHT_CONTROL_MODULE.sch (Sheet: 5/5)
