Noniwx/Diplom/Диплом/папапапа/2.pdf

## TYPEC-304-ACP16

## TPNUP4114

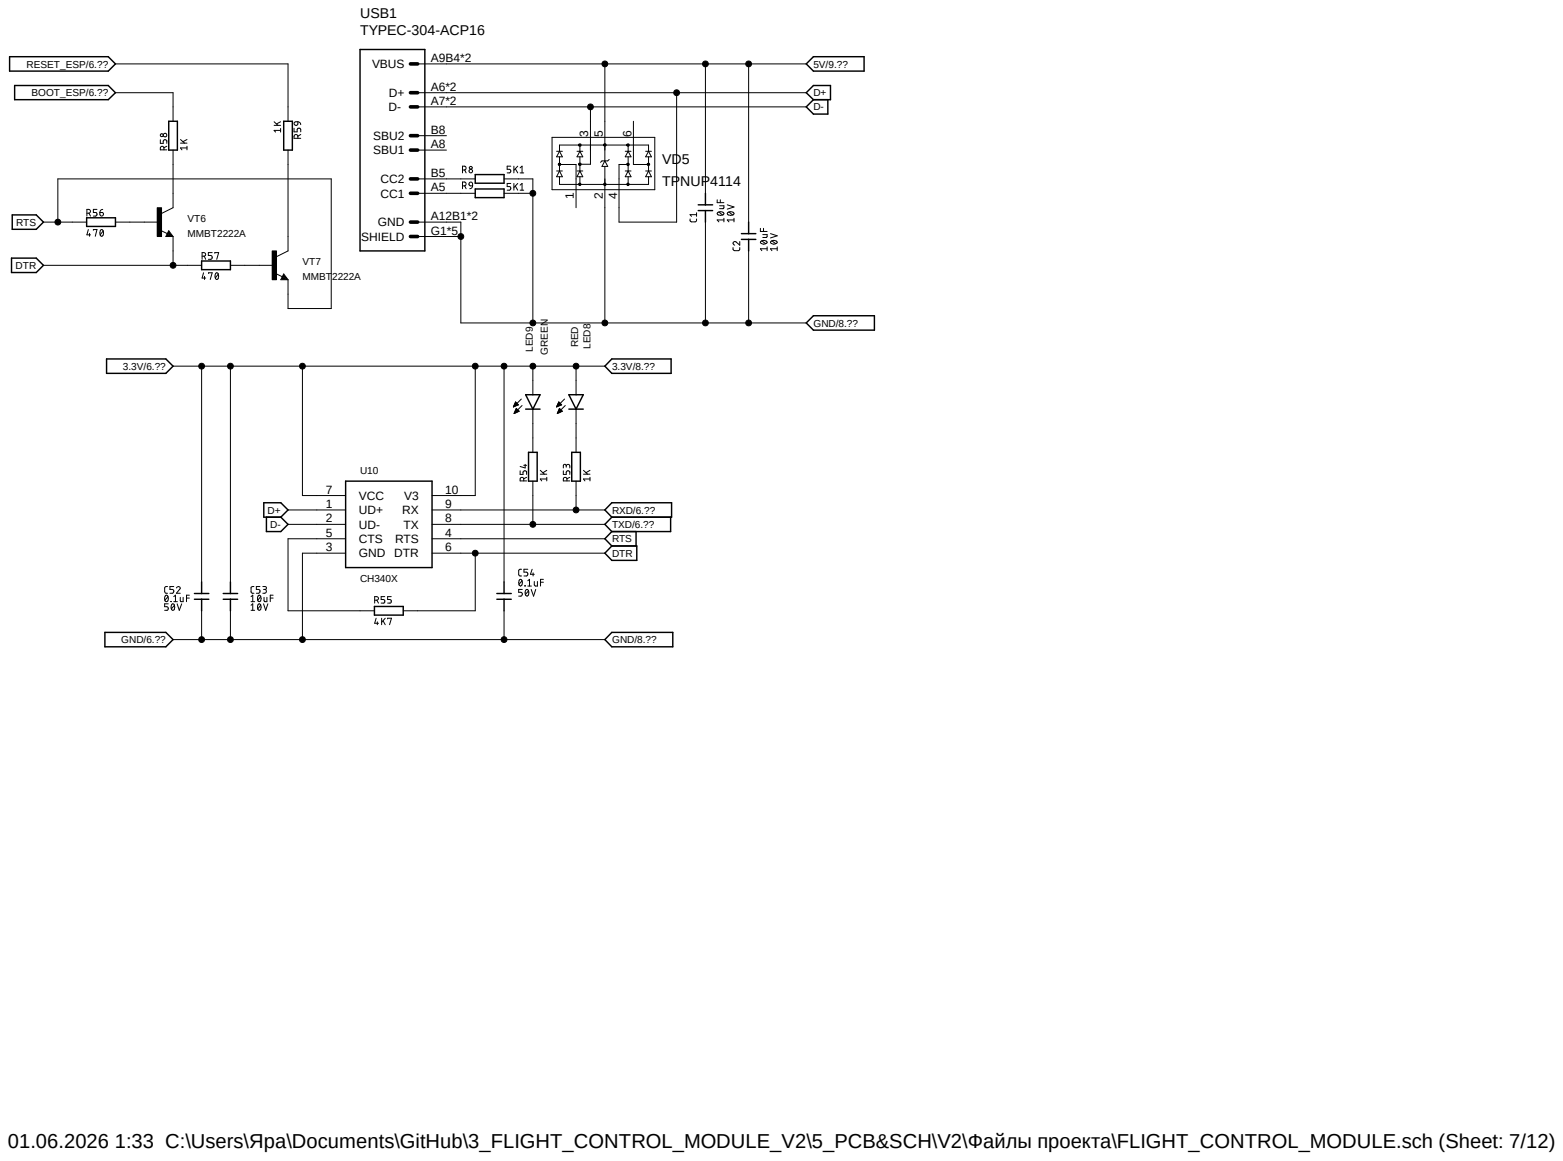
[picture p68: page 1]
MMBT2222A; RED GREEN; GND; VBUS; SBU1; A8 SBU2; SHIELD; G1*5 USB1; LED⁸ LED⁹; GND 3; VCC 7; UD+ 1 UD- 2 CTS 5; DTR; RTS; GND/8.??; GND/6.??; RXD/6.?? TXD/6.??; BOOT_ESP/6.??; RESET_ESP/6.??

01.06.2026 1:33 C:\Users\Яра\Documents\GitHub\3_FLIGHT_CONTROL_MODULE_V2\5_PCB&SCH\V2\Файлы проекта\FLIGHT_CONTROL_MODULE.sch (Sheet: 7/12)
