Noniwx/Diplom/Диплом/папапапа/3.pdf

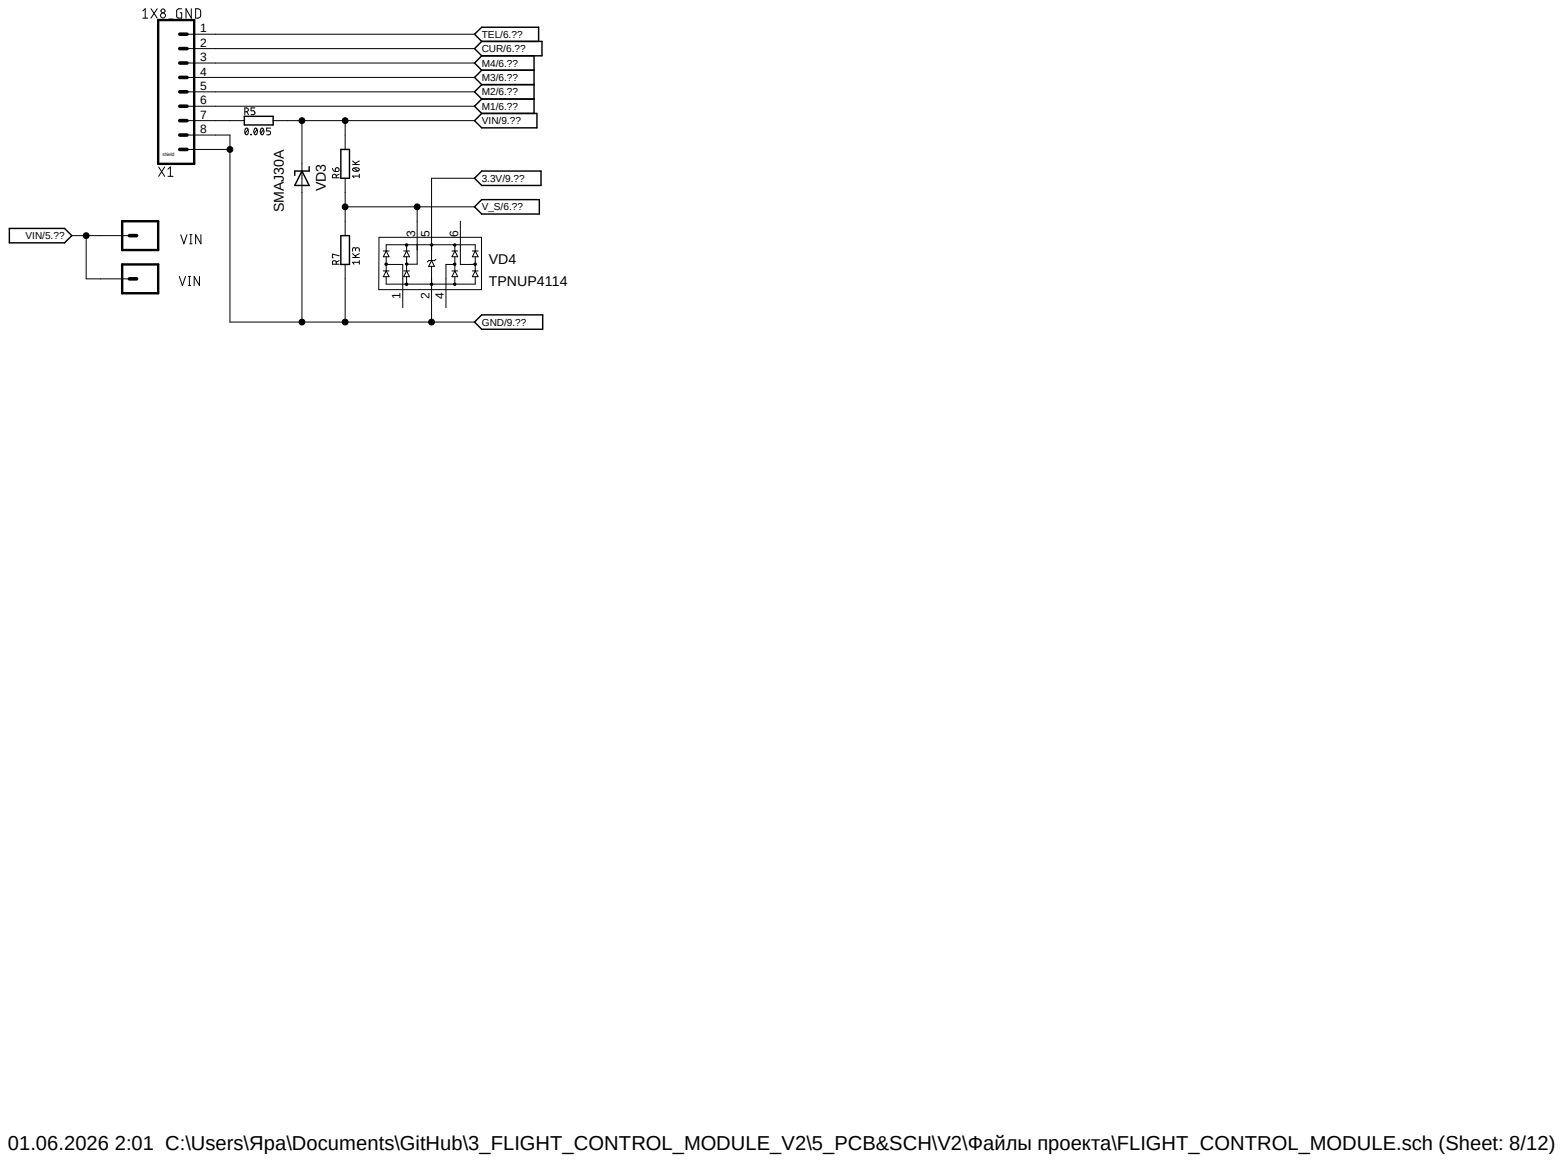
[picture p69: page 1]
TPNUP4114; 8 VD³; GND/9.??; VIN/9.??; VIN/5.??; CUR/6.??; TEL/6.??; shield

01.06.2026 2:01 C:\Users\Яра\Documents\GitHub\3_FLIGHT_CONTROL_MODULE_V2\5_PCB&SCH\V2\Файлы проекта\FLIGHT_CONTROL_MODULE.sch (Sheet: 8/12) SMAJ30A
