Noniwx/Diplom/Диплом/папапапа/4.pdf

# 10uH RED

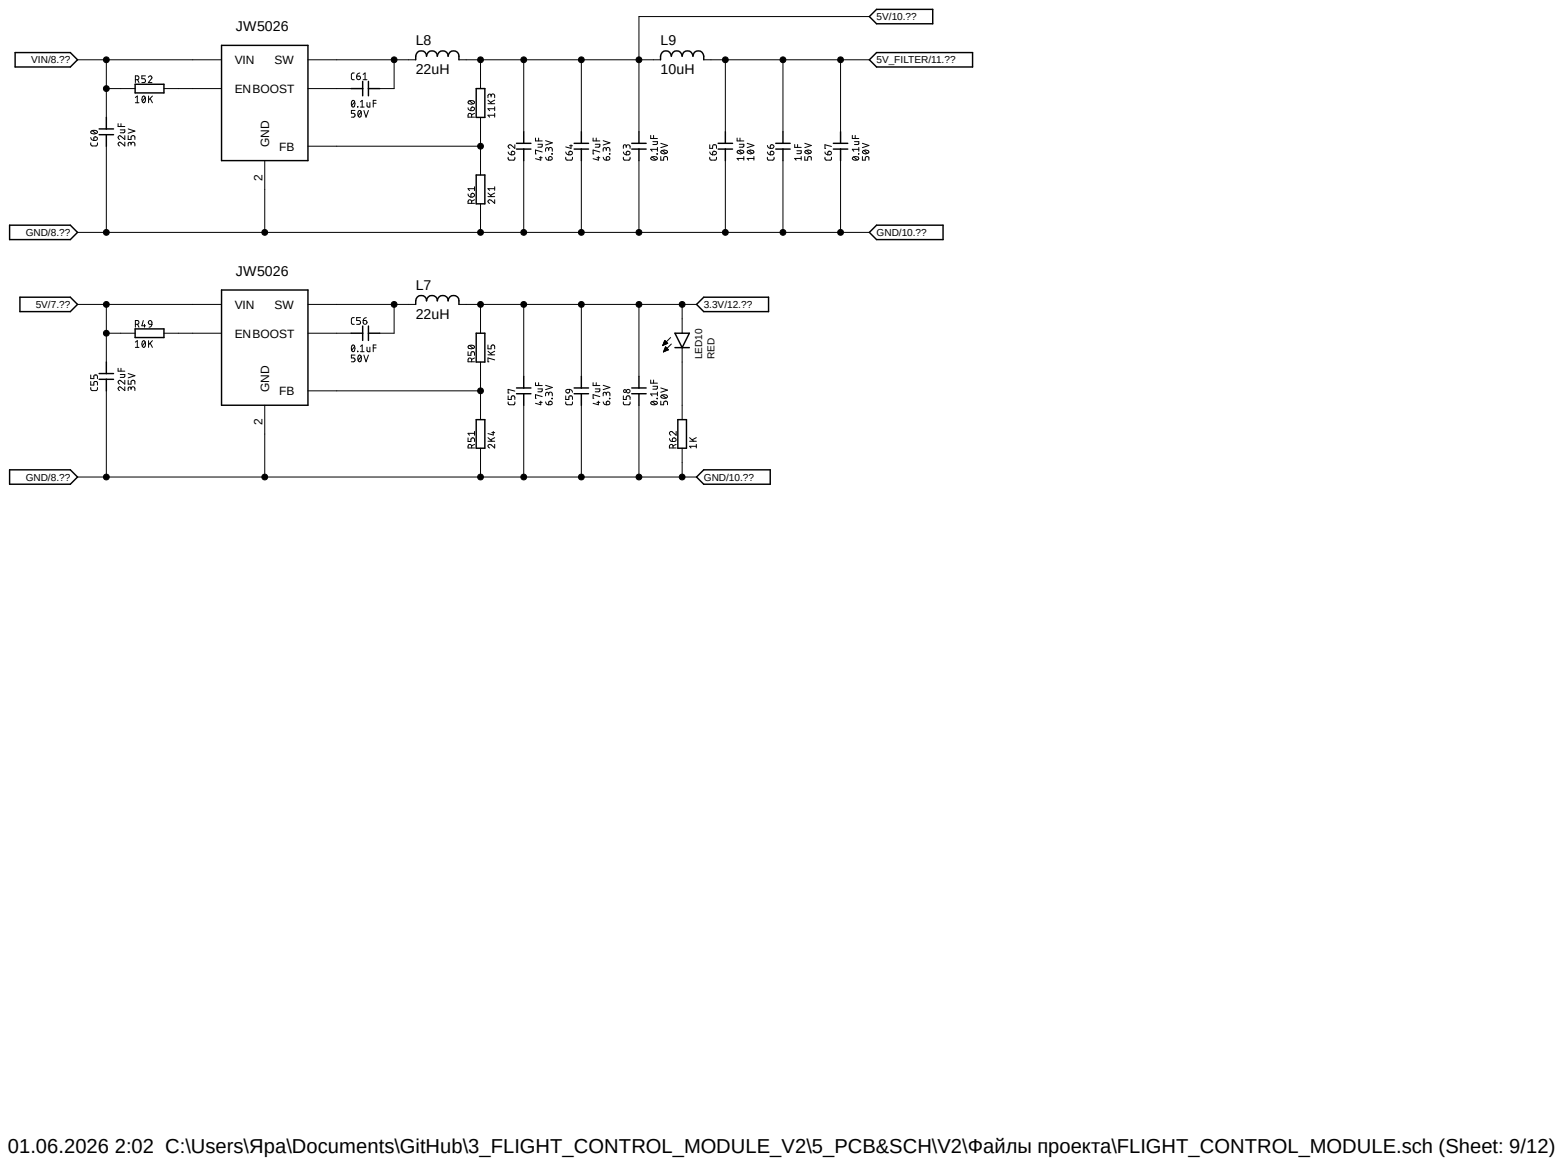
[picture p70: page 1]
L7 GND; BOOST; VIN; L8 GND; LED¹⁰; GND/8.??; GND/10.??; VIN/8.??; 5V_FILTER/11.??

01.06.2026 2:02 C:\Users\Яра\Documents\GitHub\3_FLIGHT_CONTROL_MODULE_V2\5_PCB&SCH\V2\Файлы проекта\FLIGHT_CONTROL_MODULE.sch (Sheet: 9/12)
