Noniwx/Diplom/Диплом/папапапа/5.pdf

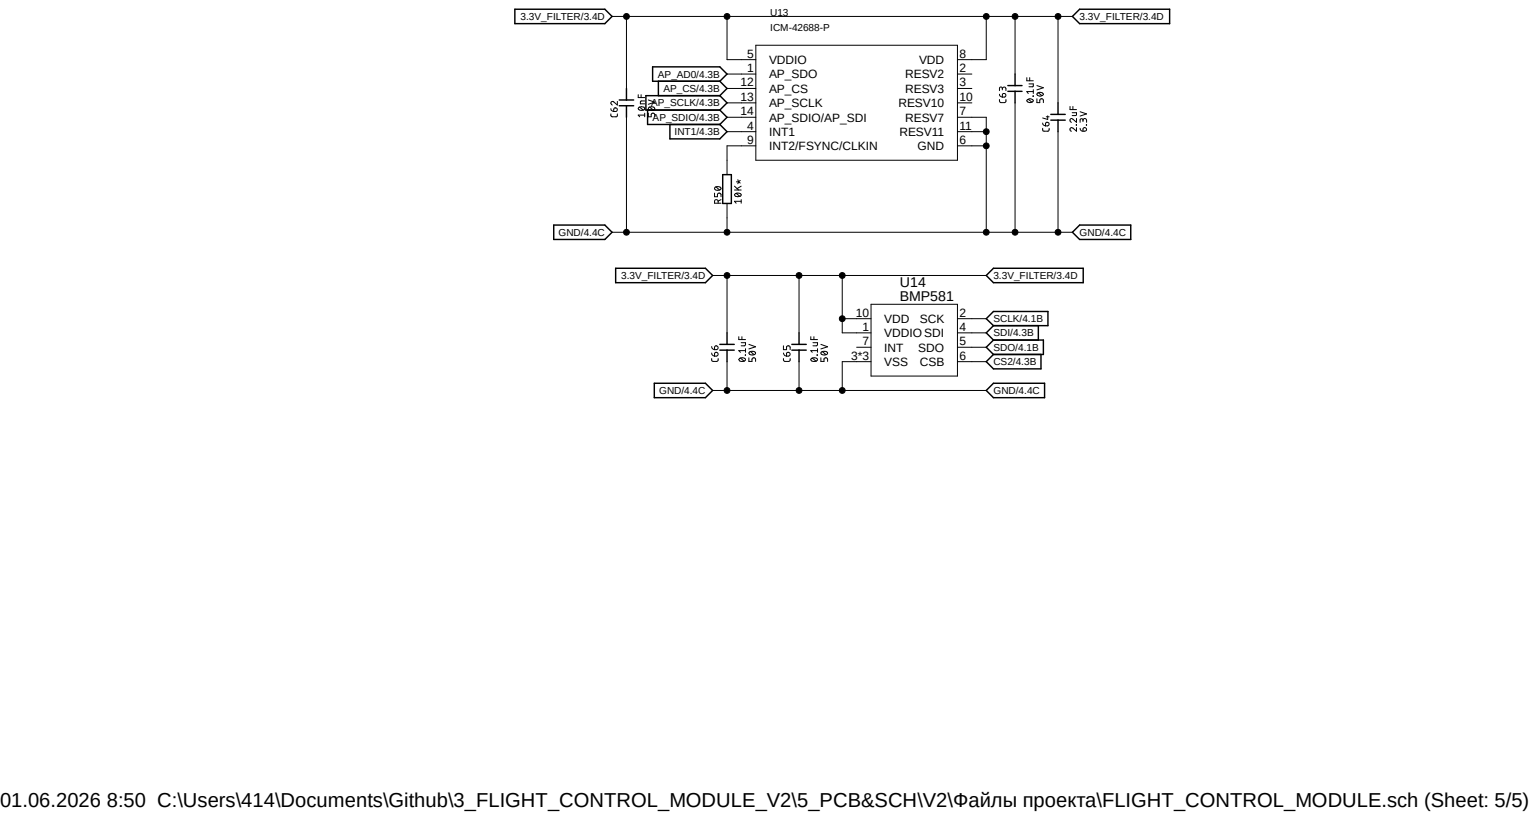
[picture p71: page 1]
ICM-42688-P; BMP581; AP_SDO 1; INT1 4 INT2/FSYNC/CLKIN 9; AP_CS 12 AP_SCLK 13 AP_SDIO/AP_SDI 14; RESV2; RESV3; RESV7; RESV10; RESV11; VDD; GND; VDDIO 5; VDDIO 1; SCK; VSS 3*3; SDI; SDO; CSB; INT 7; VDD 10; GND/4.4C; AP_AD0/4.3B AP_CS/4.3B AP_SCLK/4.3B AP_SDIO/4.3B INT1/4.3B; SCLK/4.1B; 3.3V_FILTER/3.4D; SDO/4.1B; SDI/4.3B

01.06.2026 8:50 C:\Users\414\Documents\Github\3_FLIGHT_CONTROL_MODULE_V2\5_PCB&SCH\V2\Файлы проекта\FLIGHT_CONTROL_MODULE.sch (Sheet: 5/5)
