Noniwx/Diplom/Диплом/папапапа/6.pdf

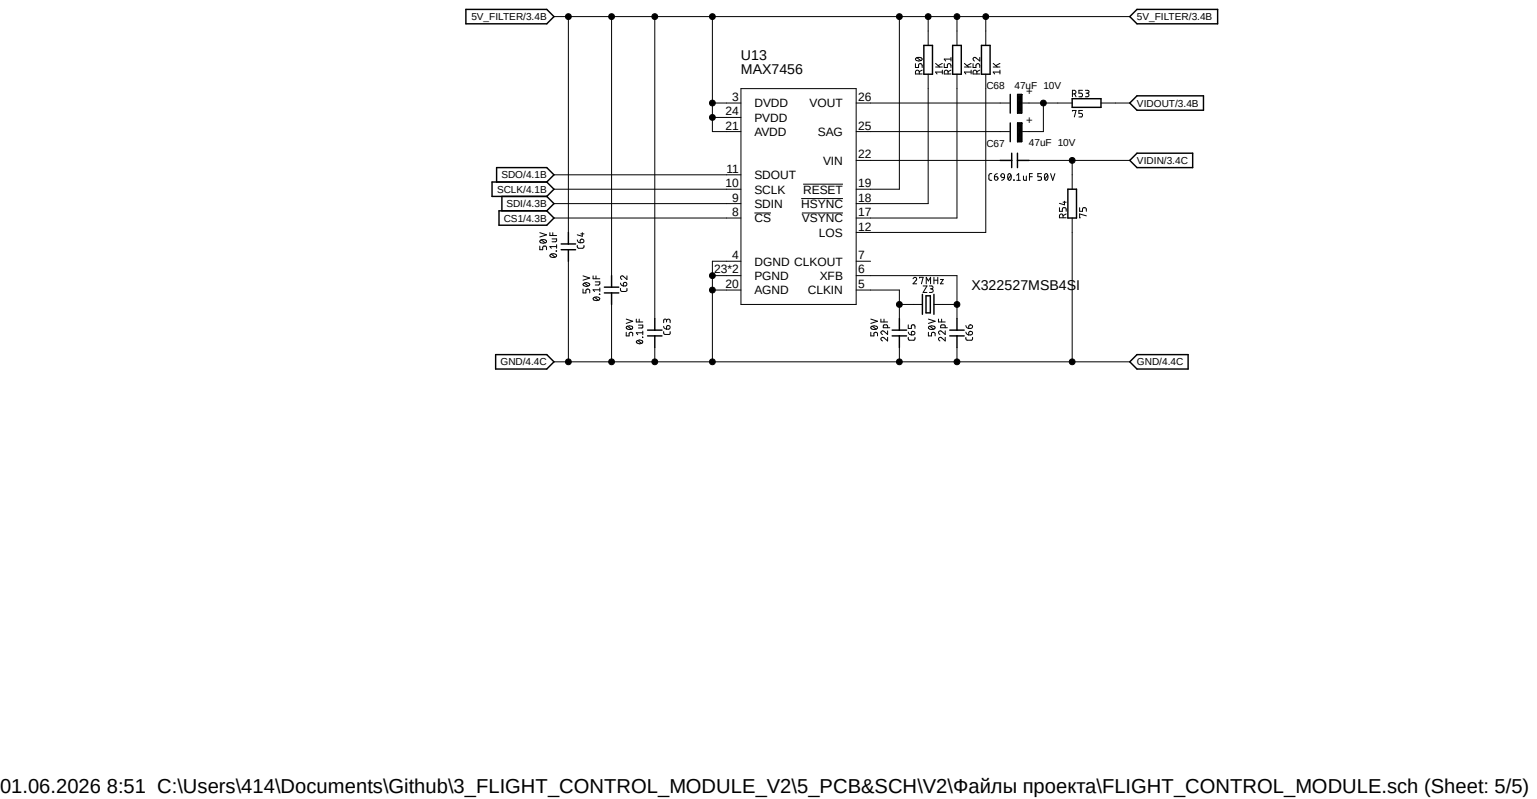
[picture p72: page 1]
X322527MSB4SI; 10V MAX7456; DVDD 3; DGND 4; CLKIN; XFB; CLKOUT; SDIN 9; SCLK 10; SDOUT 11; LOS; 12 VSYNC; 17 HSYNC; 18 RESET; AGND 20; AVDD 21; VIN; PGND 23*2; PVDD 24; SAG; VOUT; GND/4.4C; SCLK/4.1B; VIDOUT/3.4B; 5V_FILTER/3.4B; VIDIN/3.4C; SDO/4.1B; SDI/4.3B

01.06.2026 8:51 C:\Users\414\Documents\Github\3_FLIGHT_CONTROL_MODULE_V2\5_PCB&SCH\V2\Файлы проекта\FLIGHT_CONTROL_MODULE.sch (Sheet: 5/5)
