Noniwx/Diplom/Диплом/папапапа/7.pdf

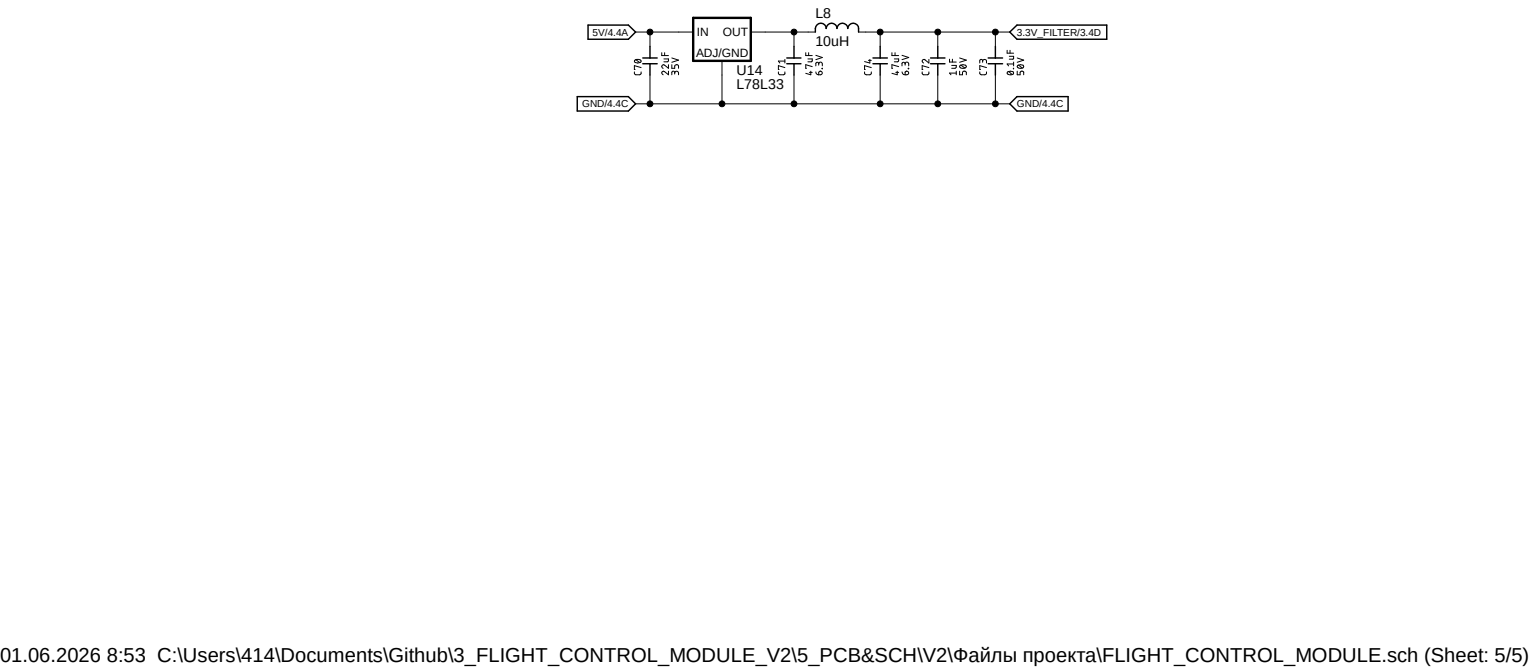
[picture p73: page 1]
ADJ/GND; IN OUTU14; GND/4.4C; 3.3V_FILTER/3.4D

01.06.2026 8:53 C:\Users\414\Documents\Github\3_FLIGHT_CONTROL_MODULE_V2\5_PCB&SCH\V2\Файлы проекта\FLIGHT_CONTROL_MODULE.sch (Sheet: 5/5)
