Noniwx/Diplom/Диплом/папапапа/8.pdf

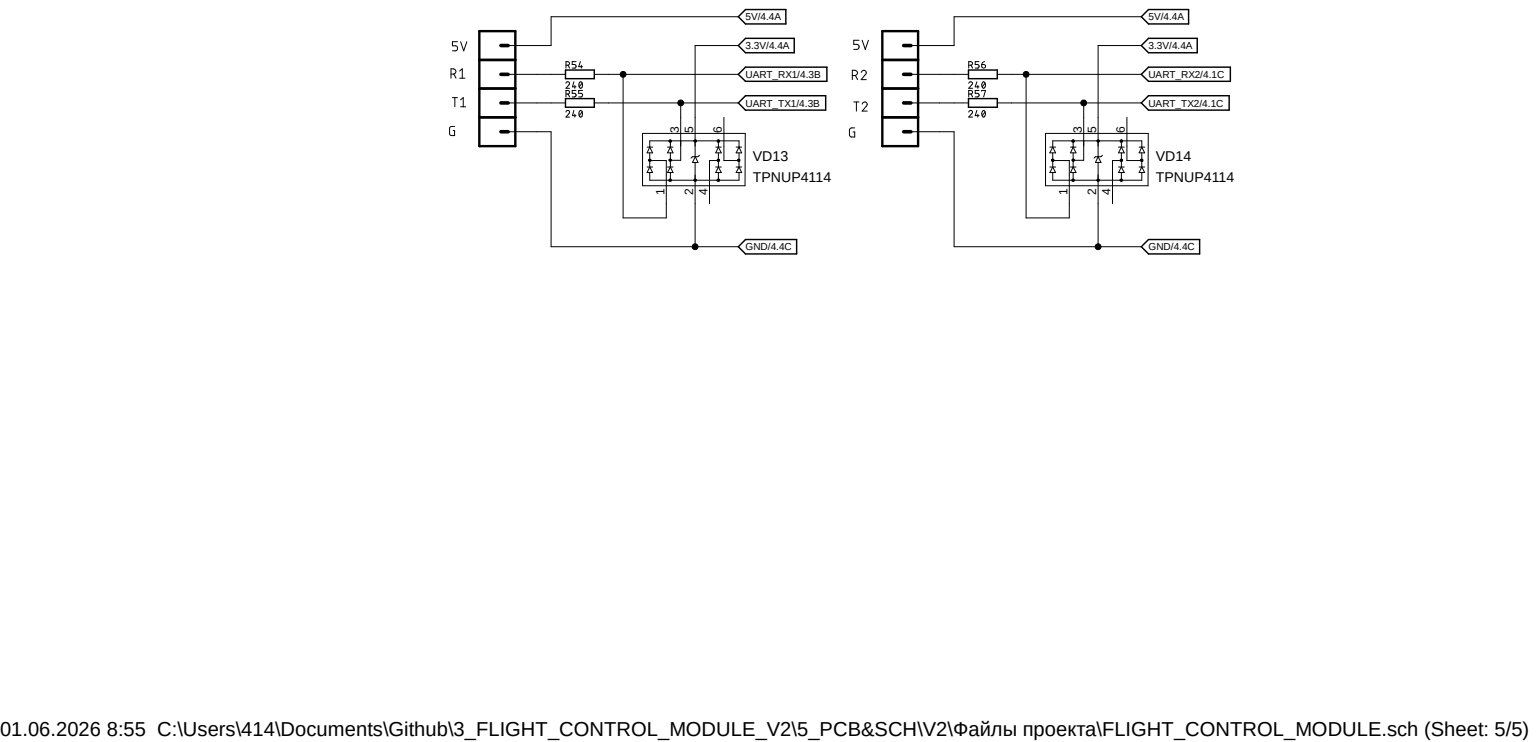
[picture p74: page 1]
TPNUP4114; GND/4.4C; UART_RX1/4.3B; UART_TX1/4.3B; UART_RX2/4.1C; UART_TX2/4.1C

01.06.2026 8:55 C:\Users\414\Documents\Github\3_FLIGHT_CONTROL_MODULE_V2\5_PCB&SCH\V2\Файлы проекта\FLIGHT_CONTROL_MODULE.sch (Sheet: 5/5)
