Noniwx/Diplom/Диплом/папапапа/9.pdf

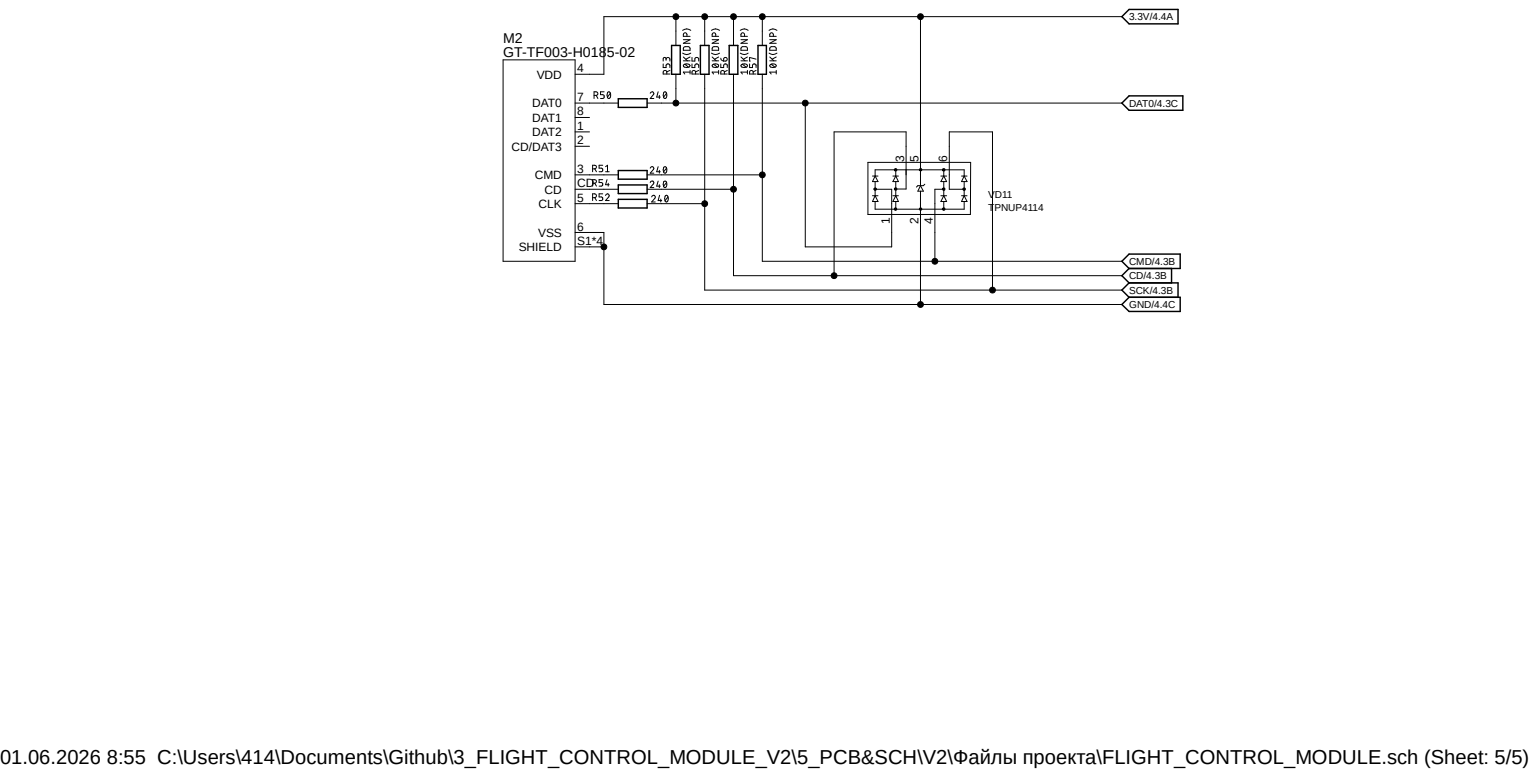
[picture p75: page 1]
TPNUP4114; DAT2; CD/DAT3; CMD; VDD; CLK; VSS; DAT0; DAT1; SHIELD; GND/4.4C; SCK/4.3B; CMD/4.3B; DAT0/4.3C

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
