Noniwx/Diplom/Диплом/папапапа/1.pdf

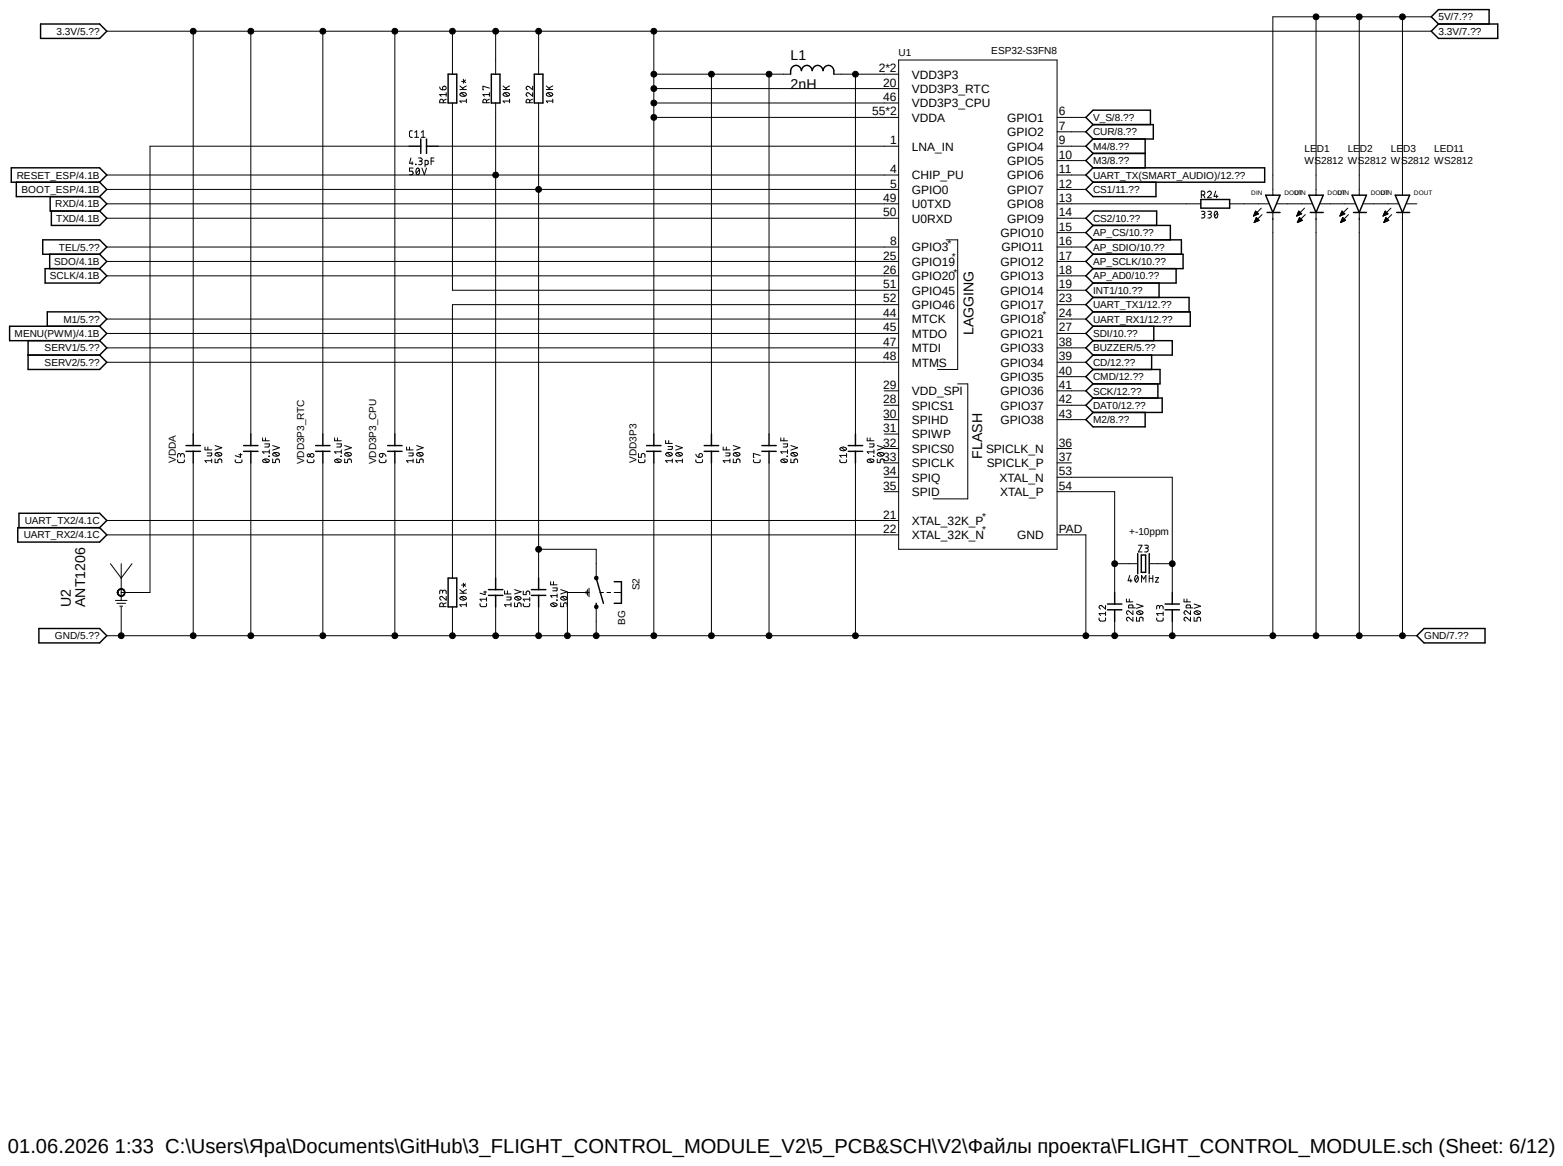
[picture p76: page 1]
01.06.2026 1:33 C:\Users\Яра\Documents\GitHub\3_FLIGHT_CONTROL_MODULE_V2\5_PCB&SCH\V2\Файлы проекта\FLIGHT_CONTROL_MODULE.sch (Sheet: 6/12) VDDA; VDD³P³_RTC; VDD³P³; +-10ppm VDD³P³_CPU; DIN; DOUTDIN; DOUT; ESP32-S3FN8 BG; WS2812 WS2812 WS2812 WS2812 2nH ANT1206; LNA_IN 1; VDD3P3 2*2; CHIP_PU 4 GPIO0 5; GPIO1; GPIO2; GPIO3 8; GPIO4; GPIO5; GPIO6; GPIO7; GPIO8; GPIO9; GPIO10; GPIO11; GPIO12; GPIO13; GPIO14; VDD3P3_RTC 20; XTAL_32K_P 21 XTAL_32K_N 22; GPIO17; GPIO18; GPIO19 25 GPIO20 26; GPIO21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
