Noniwx/Diplom/(list of files, drawings)

Other design files:
Диплом/Altium/ESP32_FPV_Flight_Controller/PCB/FlightController.PcbDoc
Диплом/Altium/ESP32_FPV_Flight_Controller/Project/ESP32_FPV_Flight_Controller/ESP32_FPV_Flight_Controller.PrjPcb
Диплом/Altium/ESP32_FPV_Flight_Controller/Schematics/Main.SchDoc
Диплом/Altium/ESP32_FPV_Flight_Controller/Schematics/Структурная схема.SchDoc
