Noniwx/Diplom/Диплом/пупупупу/Структурная схема.sch

## EAGLE design Диплом/пупупупу/Структурная схема.sch (2026-06-07)

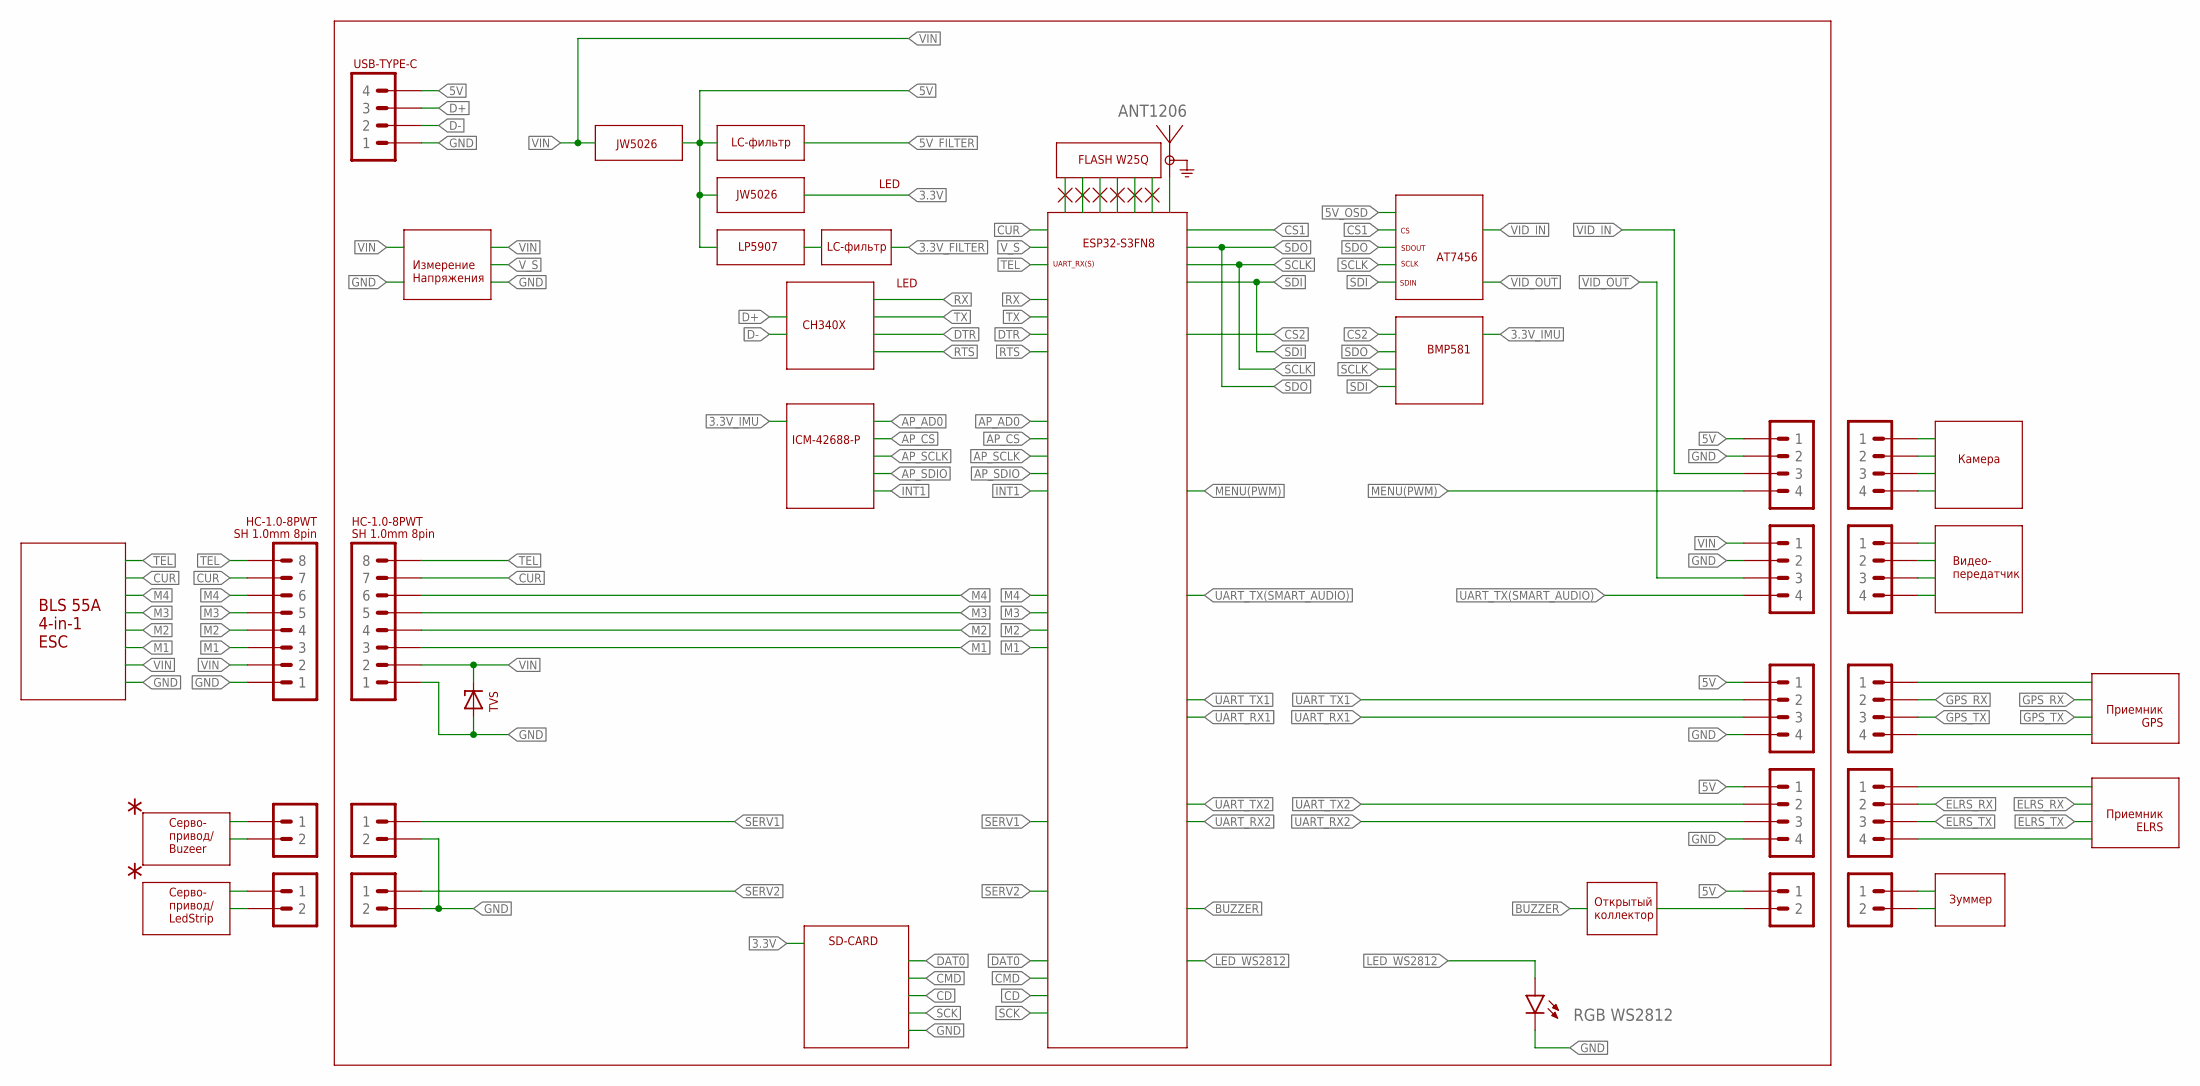
[picture p77: schematic Структурная схема.sch]

Parts:
LED2: RGB WS2812; 2013
U$2: ANT1206; 1206
X1, X2, X4, X5, X6, X7, X8, X9, X10: 1X4JST-XH-04; JST-XH-04
X3, X11: 1X8JST-XH-08; JST-XH-08
X12, X13, X23, X24, X29, X30: 1X2JST-XH-02; JST-XH-02
ZD1: ZENER-DIODESSOD123; SOD123

Connections:
5V: X1.1, X2.1, X6.1, X9.4, X12.1
CUR: X3.7, X11.7
D+: X9.3
D-: X9.2
DTR2: X4.1, X5.1
ELRS_RX: X5.2
ELRS_TX: X5.3
GND: LED2.P$1 (C), X1.4, X2.4, X3.1, X6.2, X8.2, X9.1, X11.1, X23.2, X24.2, ZD1.A
GPS_RX: X4.2
GPS_TX: X4.3
LED_WS2812: LED2.P$2 (A)
M1: X3.3, X11.3
M2: X3.4, X11.4
M3: X3.5, X11.5
M4: X3.6, X11.6
MENU(PWM): X6.4
RX2: X4.4, X5.4
SERV1: X23.1
SERV2: X24.1
TEL: X3.8, X11.8
UART_RX1: X1.3
UART_RX2: X2.3
UART_TX1: X1.2
UART_TX2: X2.2
UART_TX(SMART_AUDIO): X8.4
VID_IN: X6.3
VID_OUT: X8.3
VIN: X3.2, X8.1, X11.2, ZD1.C

Notes on the sheet:
ESP32-S3FN8
Измерение Напряжения
USB-TYPE-C
CH340X
ICM-42688-P
BMP581
Серво- привод/ Buzeer
Серво- привод/ LedStrip
Приемник ELRS
Приемник GPS
FLASH W25Q
AT7456
SDIN
SCLK
SDOUT
BLS 55A 4-in-1 ESC
Камера
UART_RX(S)
Видео- передатчик
SD-CARD
SH 1.0mm 8pin
HC-1.0-8PWT
TVS
JW5026
LP5907
LC-фильтр
LED
Зуммер
Открытый коллектор
